wpirri/dom32-io-wifi/AuxMicroSD/montaje.png

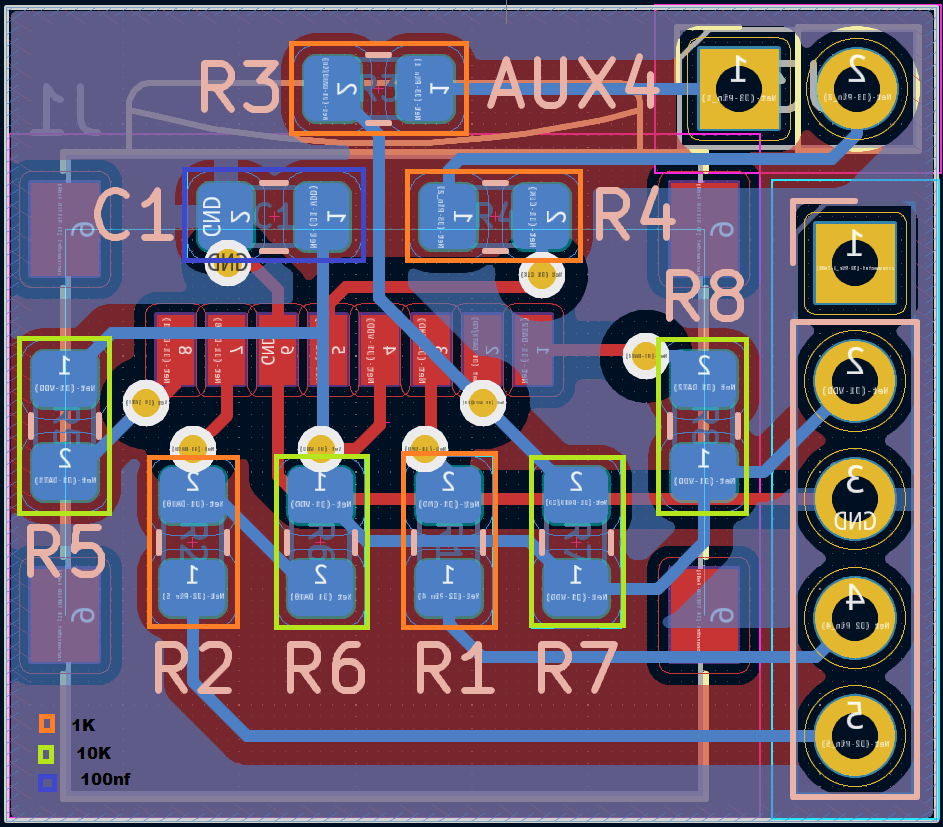
AuxMicroSD/montaje.png
