wpirri/dom32-io-wifi/Documento/Placa-LadoA.jpg

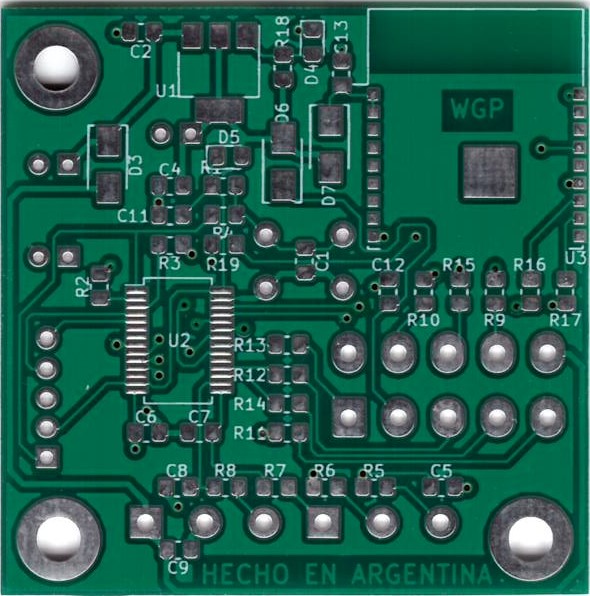
Documento/Placa-LadoA.jpg
