wpirri/dom32-io-wifi/Circuito/BOM.txt

"Component Count:","69"
"Ref","Qnty","Value","Cmp name","Footprint","Description","Vendor"
"C1, C2, C4, C5, C7, C8, C9, C10, C11, C12, C13, C16, ","12","100nf / 50v","C","Capacitor_SMD:C_0805_2012Metric_Pad1.18x1.45mm_HandSolder","Unpolarized capacitor",""
"C3, ","1","1000uf / 50v","C_Polarized","Capacitor_THT:CP_Radial_D8.0mm_P5.00mm","Polarized capacitor",""
"C6, C14, C15, C17, ","4","100uf / 16v","C_Polarized","Capacitor_THT:CP_Radial_D6.3mm_P2.50mm","Polarized capacitor",""
"D1, ","1","Led Azul","LED","Diode_SMD:D_0805_2012Metric_Pad1.15x1.40mm_HandSolder","Light emitting diode",""
"D2, ","1","Led Verde","LED","Diode_SMD:D_0805_2012Metric_Pad1.15x1.40mm_HandSolder","Light emitting diode",""
"D3, ","1","Led Amarillo","LED","Diode_SMD:D_0805_2012Metric_Pad1.15x1.40mm_HandSolder","Light emitting diode",""
"D4, D6, D7, ","3","M7","D","Diode_SMD:D_SMA","Diode",""
"D5, D8, D9, D10, D11, ","5","LL4148","D","Diode_SMD:D_SOD-128","Diode",""
"J1, ","1","Conector 1x5","Conn_01x05","Connector_PinHeader_2.54mm:PinHeader_1x05_P2.54mm_Vertical","Generic connector, single row, 01x05, script generated (kicad-library-utils/schlib/autogen/connector/)",""
"J2, J7, ","2","Bornera x2","Screw_Terminal_01x02","TerminalBlock_Phoenix:TerminalBlock_Phoenix_PT-1,5-2-5.0-H_1x02_P5.00mm_Horizontal","Generic screw terminal, single row, 01x02, script generated (kicad-library-utils/schlib/autogen/connector/)",""
"J3, J4, J6, ","3","Bornera x3","Screw_Terminal_01x03","TerminalBlock_Phoenix:TerminalBlock_Phoenix_PT-1,5-3-5.0-H_1x03_P5.00mm_Horizontal","Generic screw terminal, single row, 01x03, script generated (kicad-library-utils/schlib/autogen/connector/)",""
"J5, ","1","Conn_01x04","Conn_01x04","Connector_PinHeader_2.54mm:PinHeader_1x04_P2.54mm_Vertical","Generic connector, single row, 01x04, script generated (kicad-library-utils/schlib/autogen/connector/)",""
"K1, K2, K3, K4, ","4","FINDER-36.11","FINDER-36.11","Relay_THT:Relay_SPDT_Finder_36.11","FINDER 36.11, SPDT relay, 10A",""
"Q1, Q2, Q3, Q4, ","4","BC848","Q_NPN_BEC","Package_TO_SOT_SMD:SOT-23","NPN transistor, base/emitter/collector",""
"R1, ","1","10K","R","Resistor_SMD:R_0805_2012Metric_Pad1.20x1.40mm_HandSolder","Resistor",""
"R2, R3, R4, R5, R6, R7, R8, R9, R10, R11, R12, R15, R16, R17, R18, R19, R20, R21, ","18","1K","R","Resistor_SMD:R_0805_2012Metric_Pad1.20x1.40mm_HandSolder","Resistor",""
"R13, R14, R22, ","3","33R","R","Resistor_SMD:R_0805_2012Metric_Pad1.20x1.40mm_HandSolder","Resistor",""
"SW1, ","1","TactSwitch","SW_Push","Button_Switch_THT:SW_PUSH_6mm_H5mm","Push button switch, generic, two pins",""
"U1, ","1","ZLDO1117QG33TADICT-ND","LM1117-3.3","Package_TO_SOT_SMD:SOT-223-3_TabPin2","800mA Low-Dropout Linear Regulator, 3.3V fixed output, TO-220/TO-252/TO-263/SOT-223",""
"U2, ","1","PIC32MM0256GPM028-I-SS","PIC32MM0256GPM028-I-SS","Package_SO:SSOP-28_5.3x10.2mm_P0.65mm","",""
"U3, ","1","1965-ESP-WROOM-02D-N4CT-ND","ESP-02-DomIO32","RF_Module:ESP-WROOM-02","",""

MEM2067-02-180-00-A
