wpirri/dom32-io-wifi/Documento/Entradas y Salidas.pdf

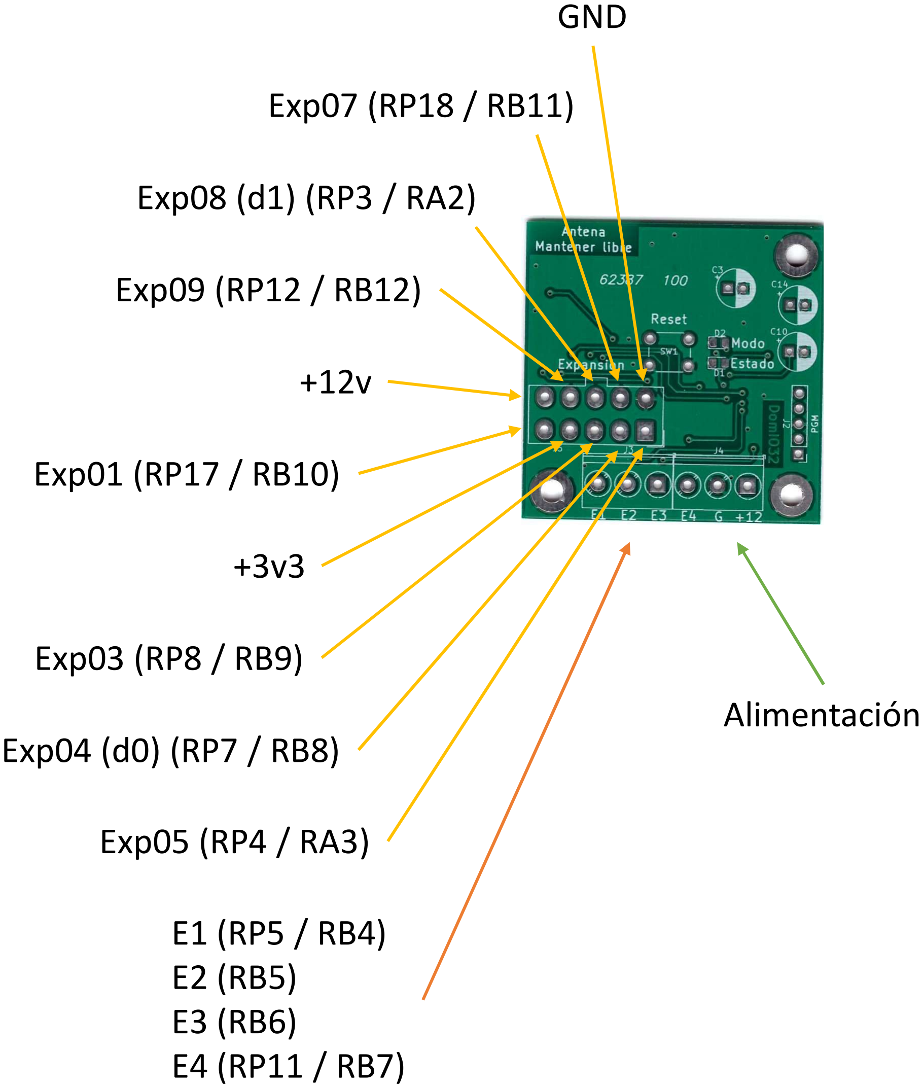
[picture p3: figure]
GND; Exp07 (RP18 / RB11); Exp08 (d1) (RP3 / RA2); Exp09 (RP12 / RB12); Exp01 (RP17 / RB10); Exp03 (RP8 / RB9); Exp04 (d0) (RP7 / RB8); Exp05 (RP4 / RA3); Alimentación
