wpirri/dom32-io-wifi/AuxMicroSD/instalacion_parche.jpg

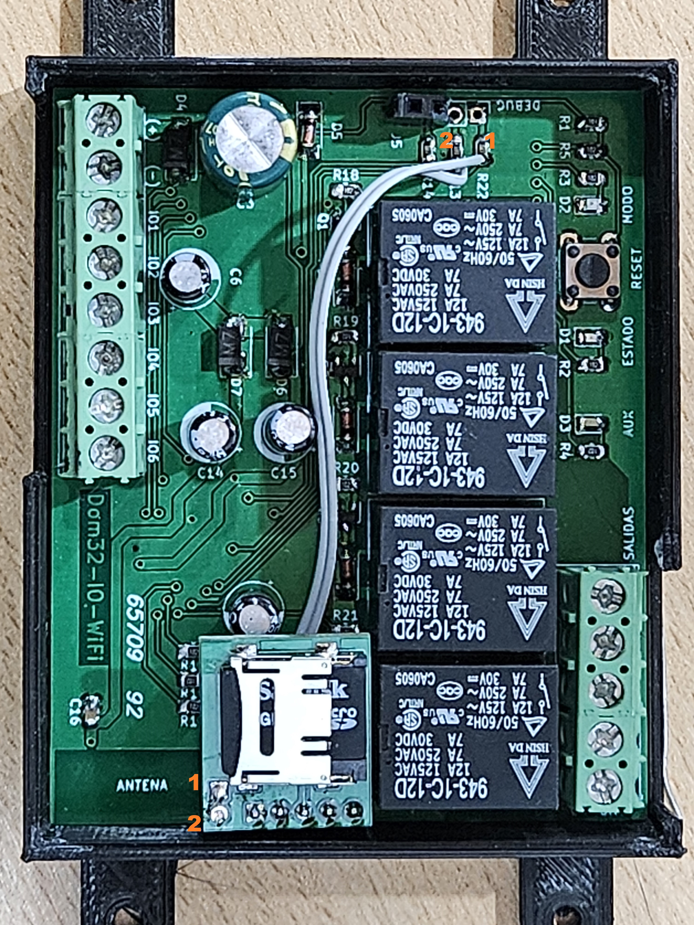
AuxMicroSD/instalacion_parche.jpg
