wpirri/dom32-io-wifi/Documento/2023-01-29 13.07.53.jpg

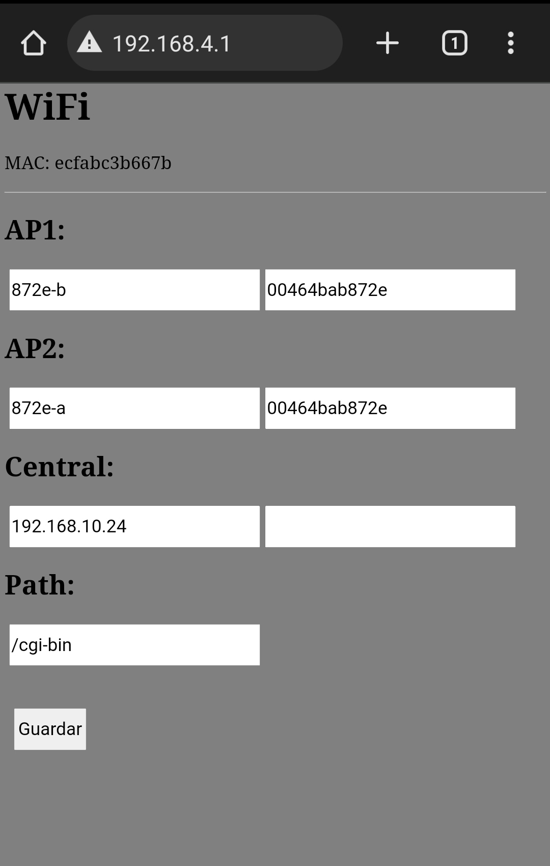
Documento/2023-01-29 13.07.53.jpg
