wpirri/dom32-io-wifi/Documento/DomIO32-3D-Fdo.jpg

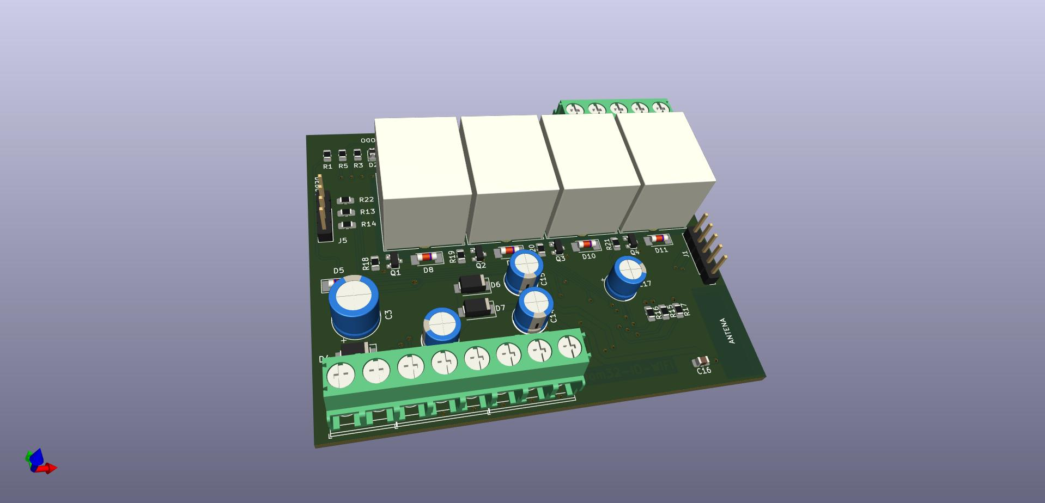
Documento/DomIO32-3D-Fdo.jpg
