wpirri/dom32-io-wifi/Documento/DomIO32-3D-Fte.jpg

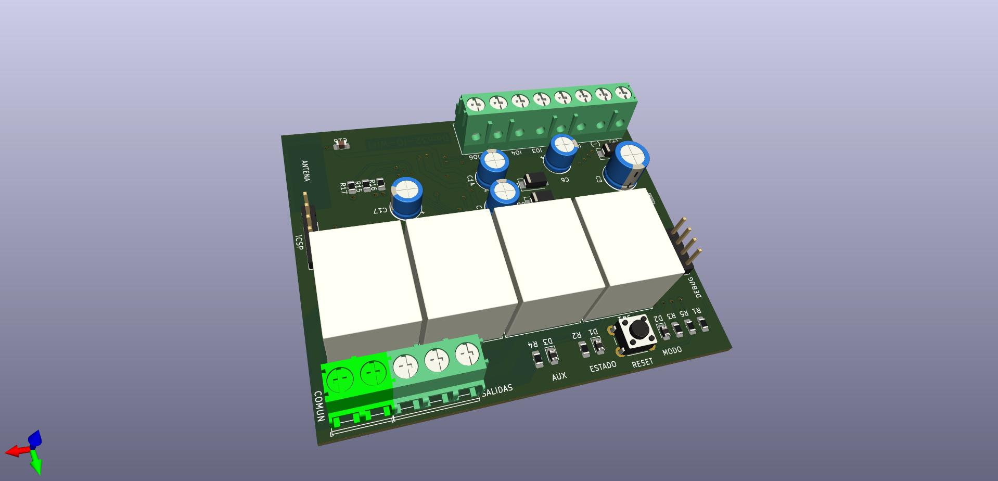
Documento/DomIO32-3D-Fte.jpg
