wpirri/dom32-io-wifi/Documento/DomIO32-3D-Inf.jpg

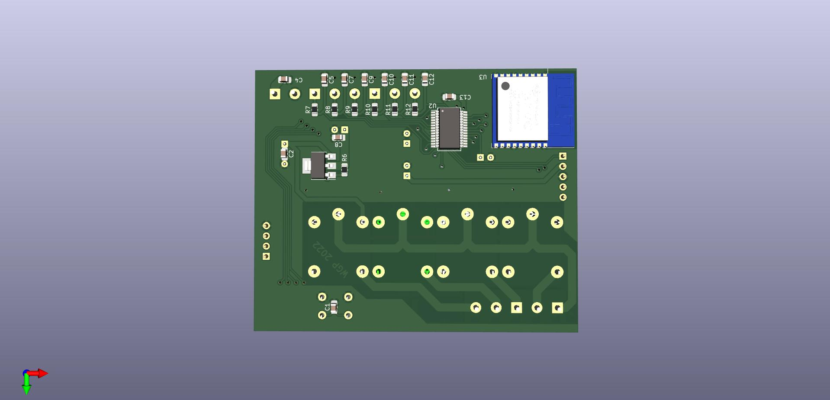
Documento/DomIO32-3D-Inf.jpg
