wpirri/dom32-io-wifi/Documento/DomIO32-3D-Sup.jpg

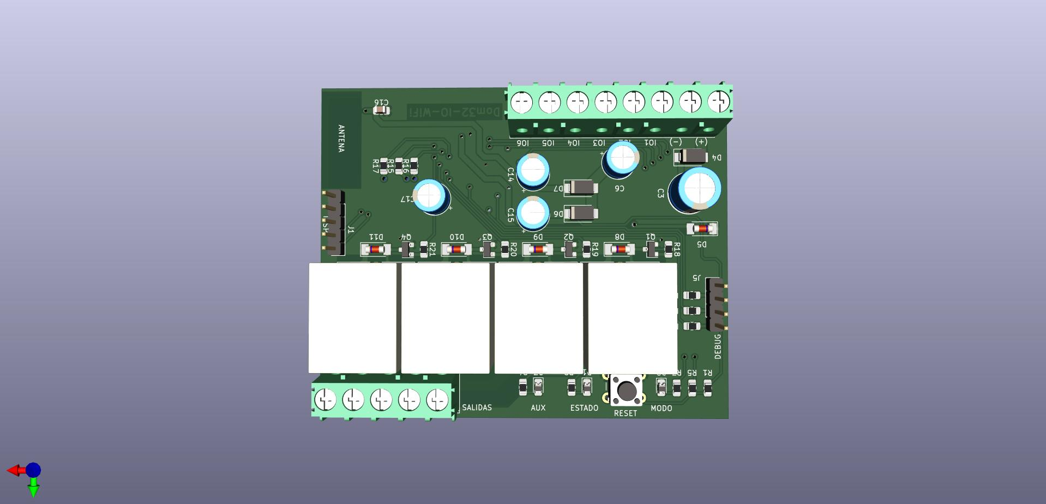
Documento/DomIO32-3D-Sup.jpg
