wpirri/dom32-io-wifi/Documento/getio.png

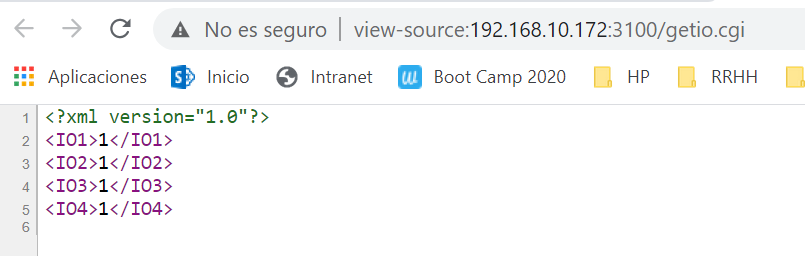
Documento/getio.png
