wpirri/dom32-io-wifi/Documento/Placa-LadoB.jpg

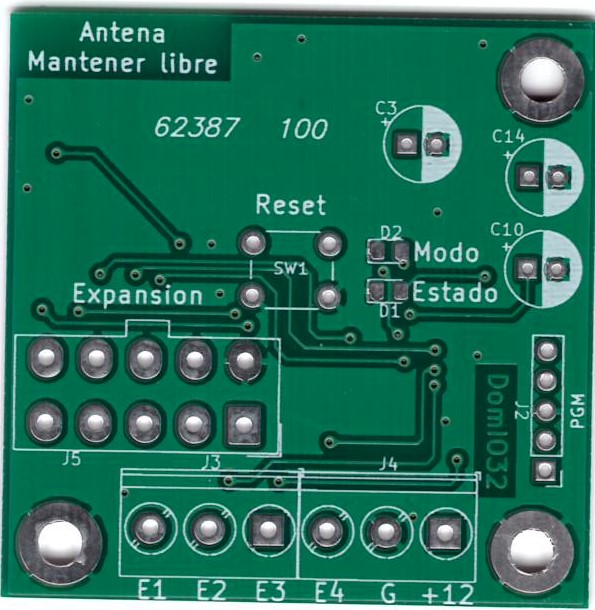
Documento/Placa-LadoB.jpg
