wpirri/dom32-io-wifi/Documento/placa.png

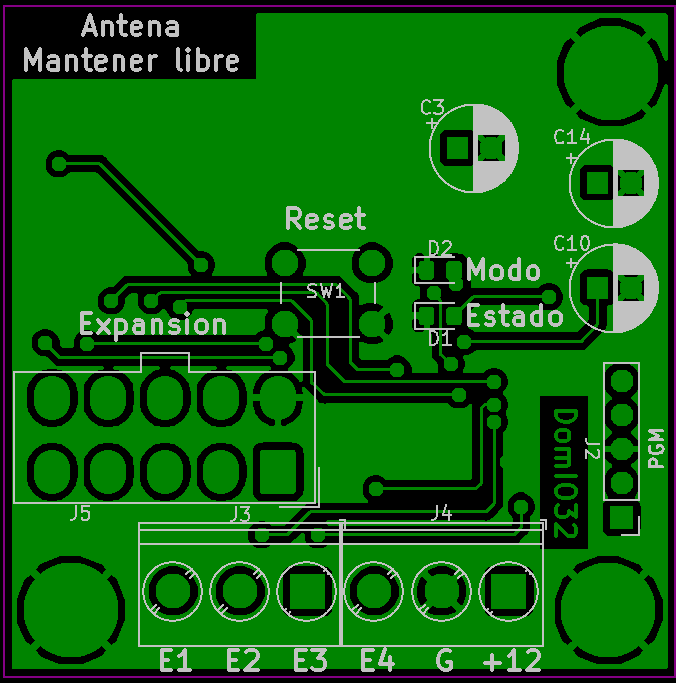
Documento/placa.png
