wpirri/dom32-io-wifi/Documento/Componentes.txt

ESP-WROOM-02D

PIC32MM0256GPM028-I/SS

Alternativas:
    PIC32MM0256GPM028-E/SS      Rango extendido de temperaturas
    PIC32MM0256GPM028T-I/SS     Embalado en Tape & Reel

Orificio 1,25

Conector
CONN RCPT HSG 10POS 4.20MM
DKPN: WM19548-ND

CONN HEADER VERT 10POS 4.2MM
DKPN: WM20747-ND
