wpirri/dom32-io-wifi/Documento/Materiales.xlsx

Componente | Valor | DigiKey | Cantidad | Unitario | Por placa
Resistencia SMD 0805 | 1K | 13-RC0805JR-131KLCT-ND | 18 | 0.10 | 1.80
Resistencia SMD 0805 | 10K | 311-10KARCT-ND | 1 | 0.10 | 0.10
Resistencia SMD 0805 | 33R | 311-33ARCT-ND | 3 | 0.10
Capacitor ceramico SMD 0805 | 100nf / 50v | 3372-0805B104K500BDTR-ND | 12 | 0.05 | 0.60
Capacitor electrolitico | 1000uf / 25v | 732-8835-1-ND | 1 | 0.57 | 0.57
Capacitor electrolitico | 100uf / 25v | 732-8630-1-ND | 4 | 0.13 | 0.52
Led SMD 0805 | Verde | 3147-B1701NG--20D000314U1930CT-ND | 1 | 0.11 | 0.11
Led SMD 0805 | Azul | 3147-B1701NB--20D000114U1930CT-ND | 1 | 0.10 | 0.10
Led SMD 0805 | Amarillo | 3147-B1701UY--20D000214U1930CT-ND | 1 | 0.10 | 0.10
Diodo | M7 | 3372-M7TR-ND | 3 | 0.10 | 0.30
Diodo | LL4148 | LL4148-GS08CT-ND | 5 | 0.17 | 0.85
Transistor | BC847 | BC847C-TPCT-ND | 4 | 0.14 | 0.56
Bornera x 2 | DG128-B2V | 277-1667-ND | 2 | 0.52 | 1.04
Bornera x 3 | DG128-B3V | 277-1578-ND | 3 | 0.71 | 2.13
Relee 12v 10A | 943-Series | 3385-AZ943-1CH-12DE-ND | 4 | 0.65 | 2.60
Tact Switch | 6x6x5 mm | 486-3458-ND | 1 | 0.23 | 0.23
Regulador SOT-223 | ZLDO1117 | ZLDO1117QG33TADICT-ND | 1 | 0.67 | 0.67
Procesador | PIC32MM0256GPM028-I/SS (E/SS) | PIC32MM0256GPM028-I/SS-ND | 1 | 2.92 | 2.92
Modulo Wifi | ESP-WROOM-02 | 1965-ESP-WROOM-02D-N4CT-ND | 1 | 3.20 | 3.20
Circuito impreso | MAYER_65709-42 |  | 1 | 7.40 | 7.40
 |  |  |  |  | 0.00
 |  |  |  |  | 0.00
 |  |  |  |  | 0.00
 |  |  |  |  | 0.00
 |  |  |  |  | 0.00
 |  |  | Total |  | 25.80
