wpirri/dom32-io-wifi/Gabinete/dom32-io-wifi-tapa-con-logo.3mf

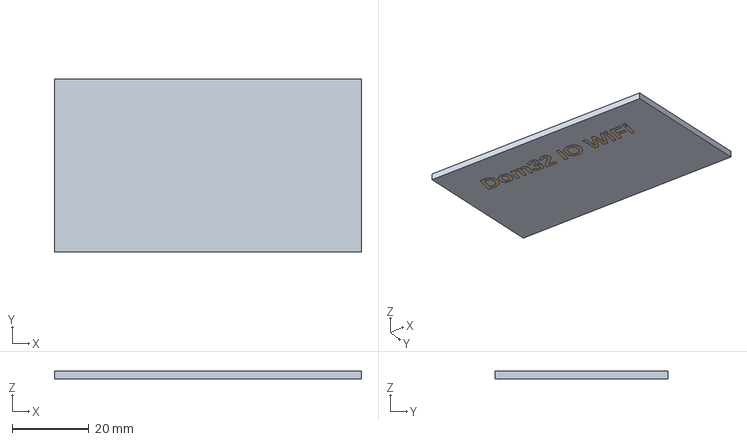
[picture p13: CAD file, 2022-09-06]
Gabinete/dom32-io-wifi-tapa-con-logo.3mf
80.0 x 45.0 x 2.00 mm
dom32-io-wifi-gabinete-tapa-superior.stl
dom32-io-wifi-gabinete-logo.stl
