wpirri/dom32-io-wifi/Gabinete/TODO.txt

Ranuras de ventilacion para sensor de humedad y temperatura
