wpirri/dom32-io-wifi/Circuito/DomIO32v2.pdf

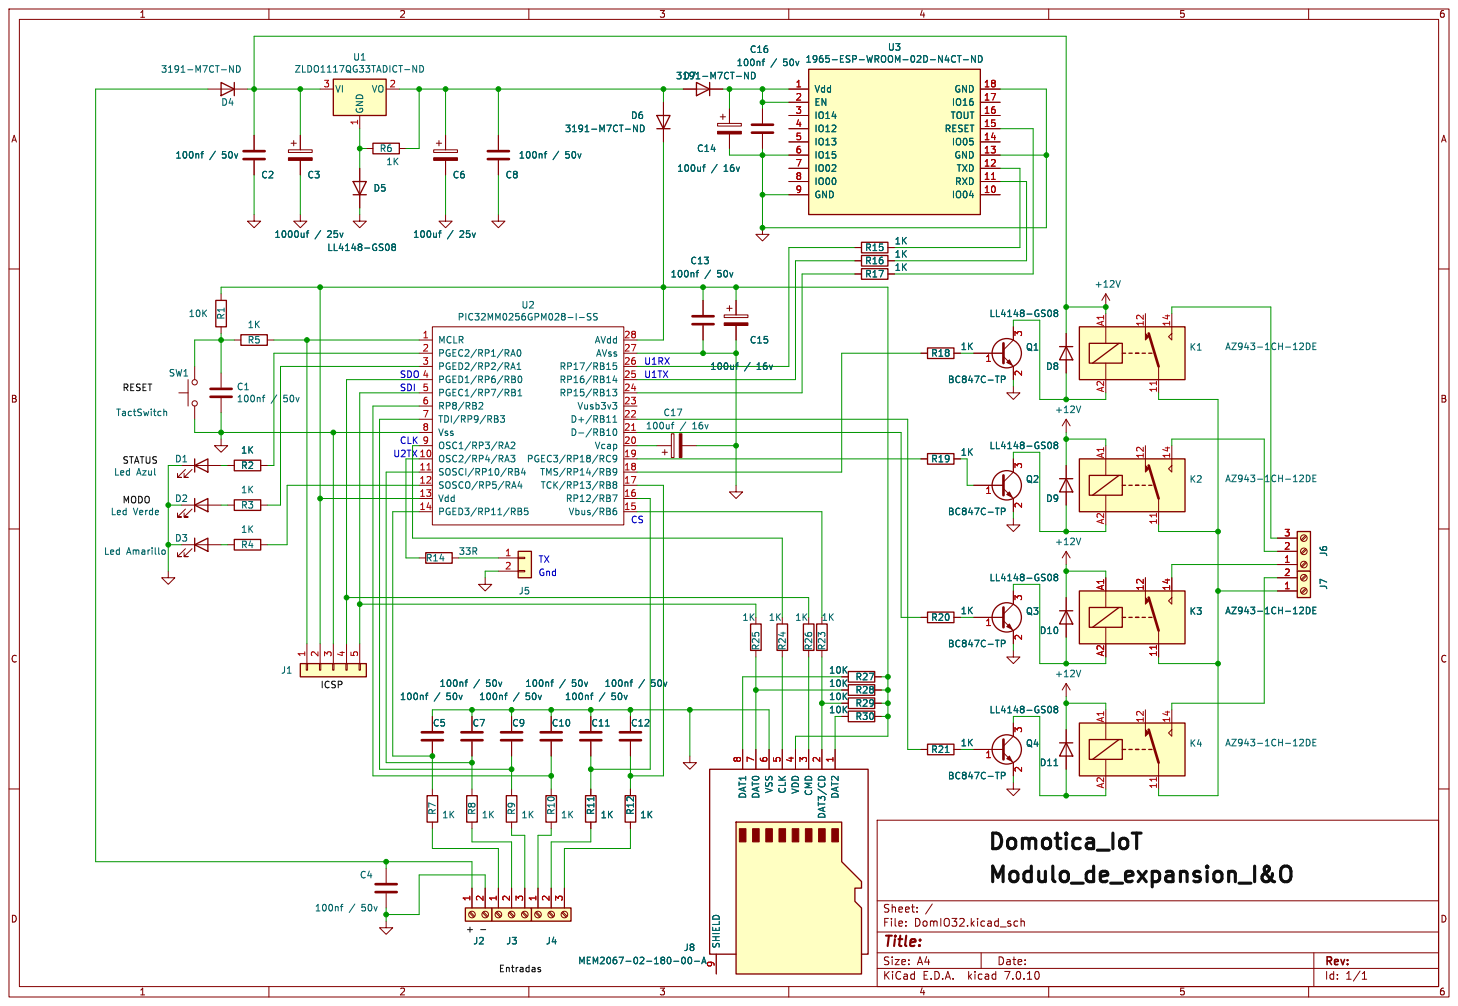
[picture p17: page 1]

1 VO 2 VI 3 U1 ZLDO1117QG33TADICT-ND 3191-M7CT-ND D7 C1

Id: 1/1 Title: File: DomIO32.kicad_sch Sheet: /
