wpirri/dom32-io-wifi/Circuito/DomIO32.pdf

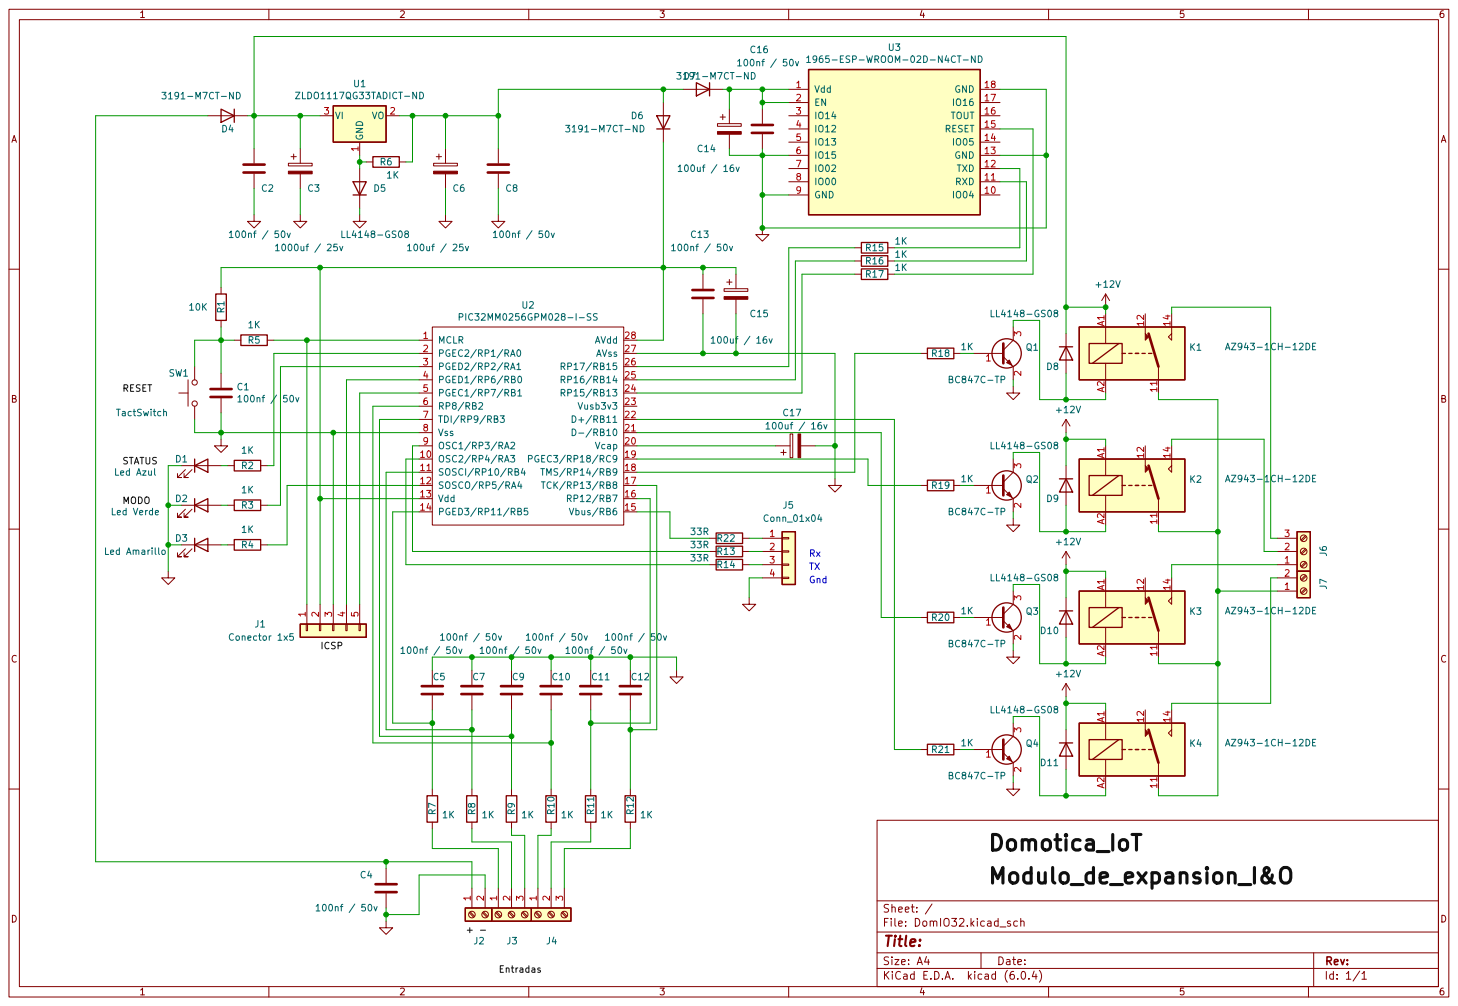
[picture p18: page 1]
