wpirri/dom32-io-wifi/Circuito/Circuito.pdf

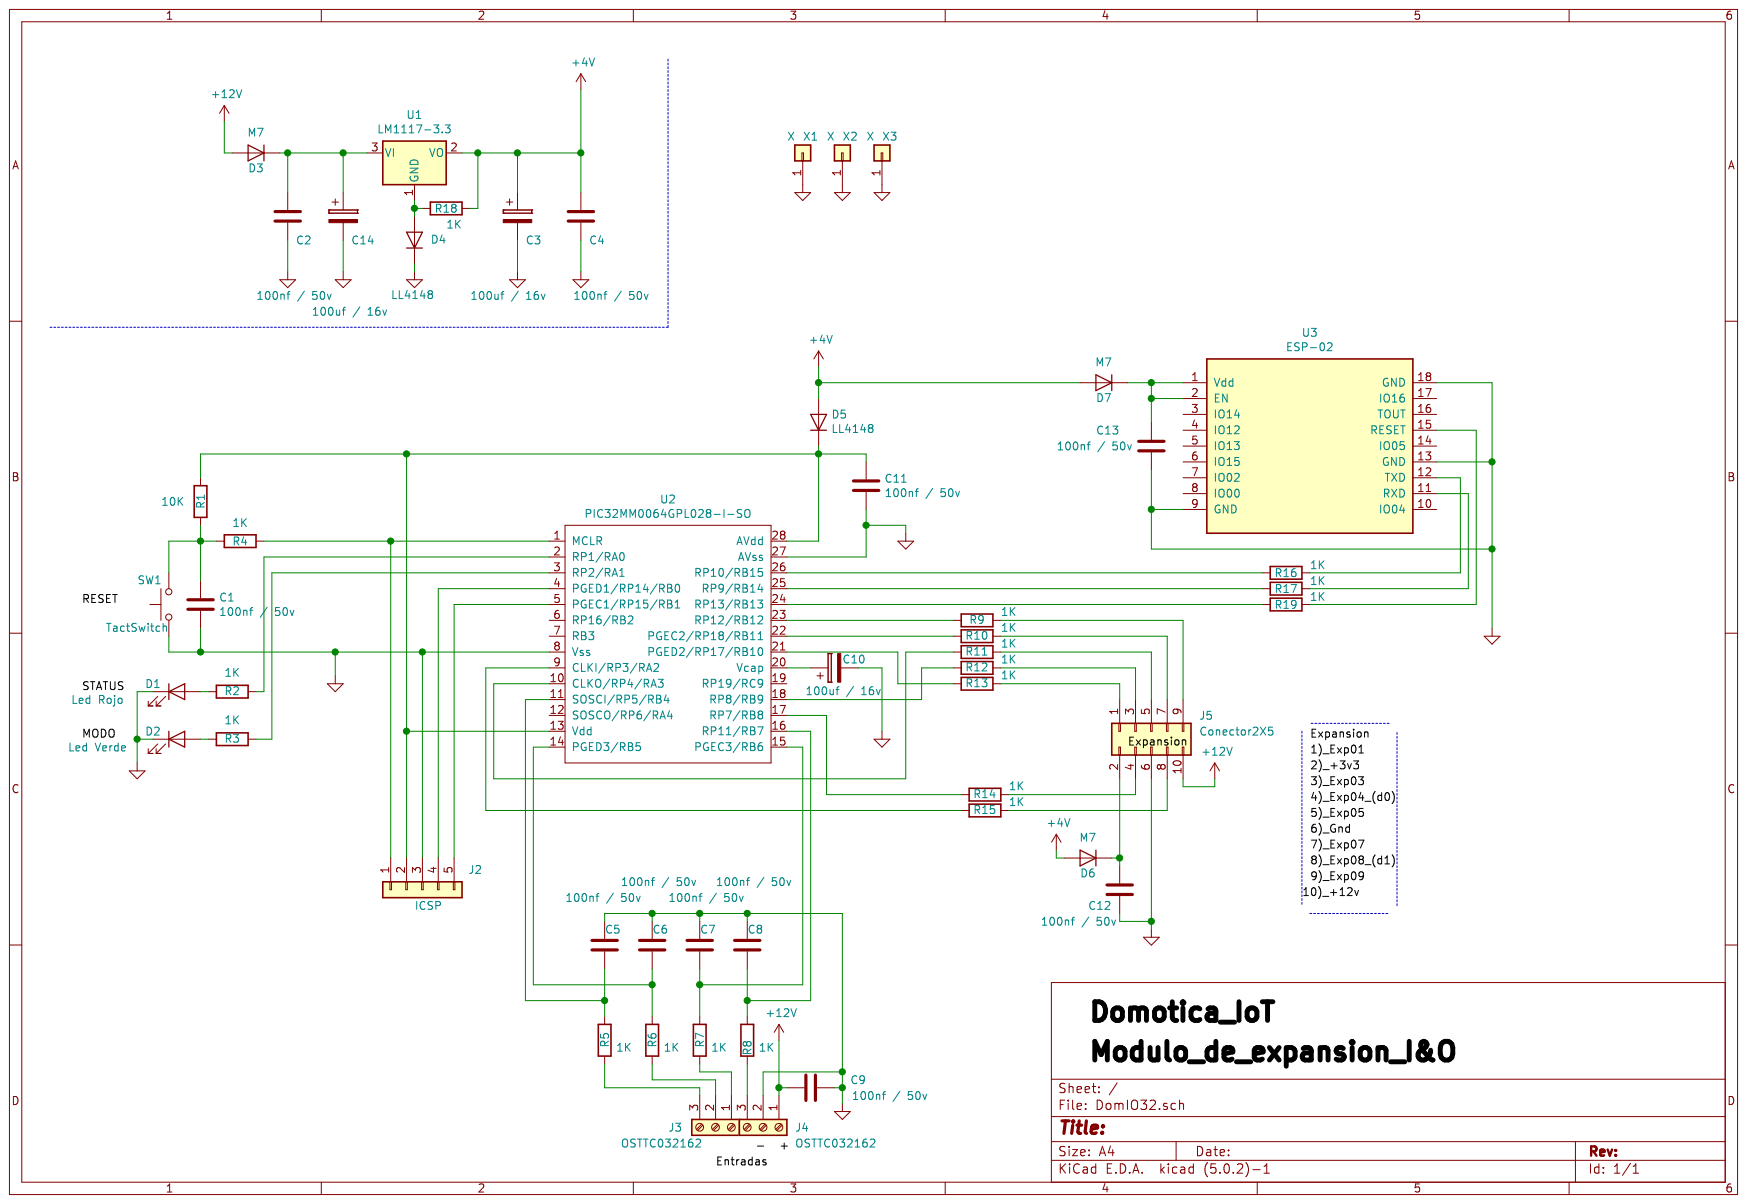
[picture p19: page 1]
