wpirri/dom32-io-wifi/Circuito/DomIO32.kicad_pcb

## KiCad design Circuito/DomIO32.kicad_pcb (2024-06-20)

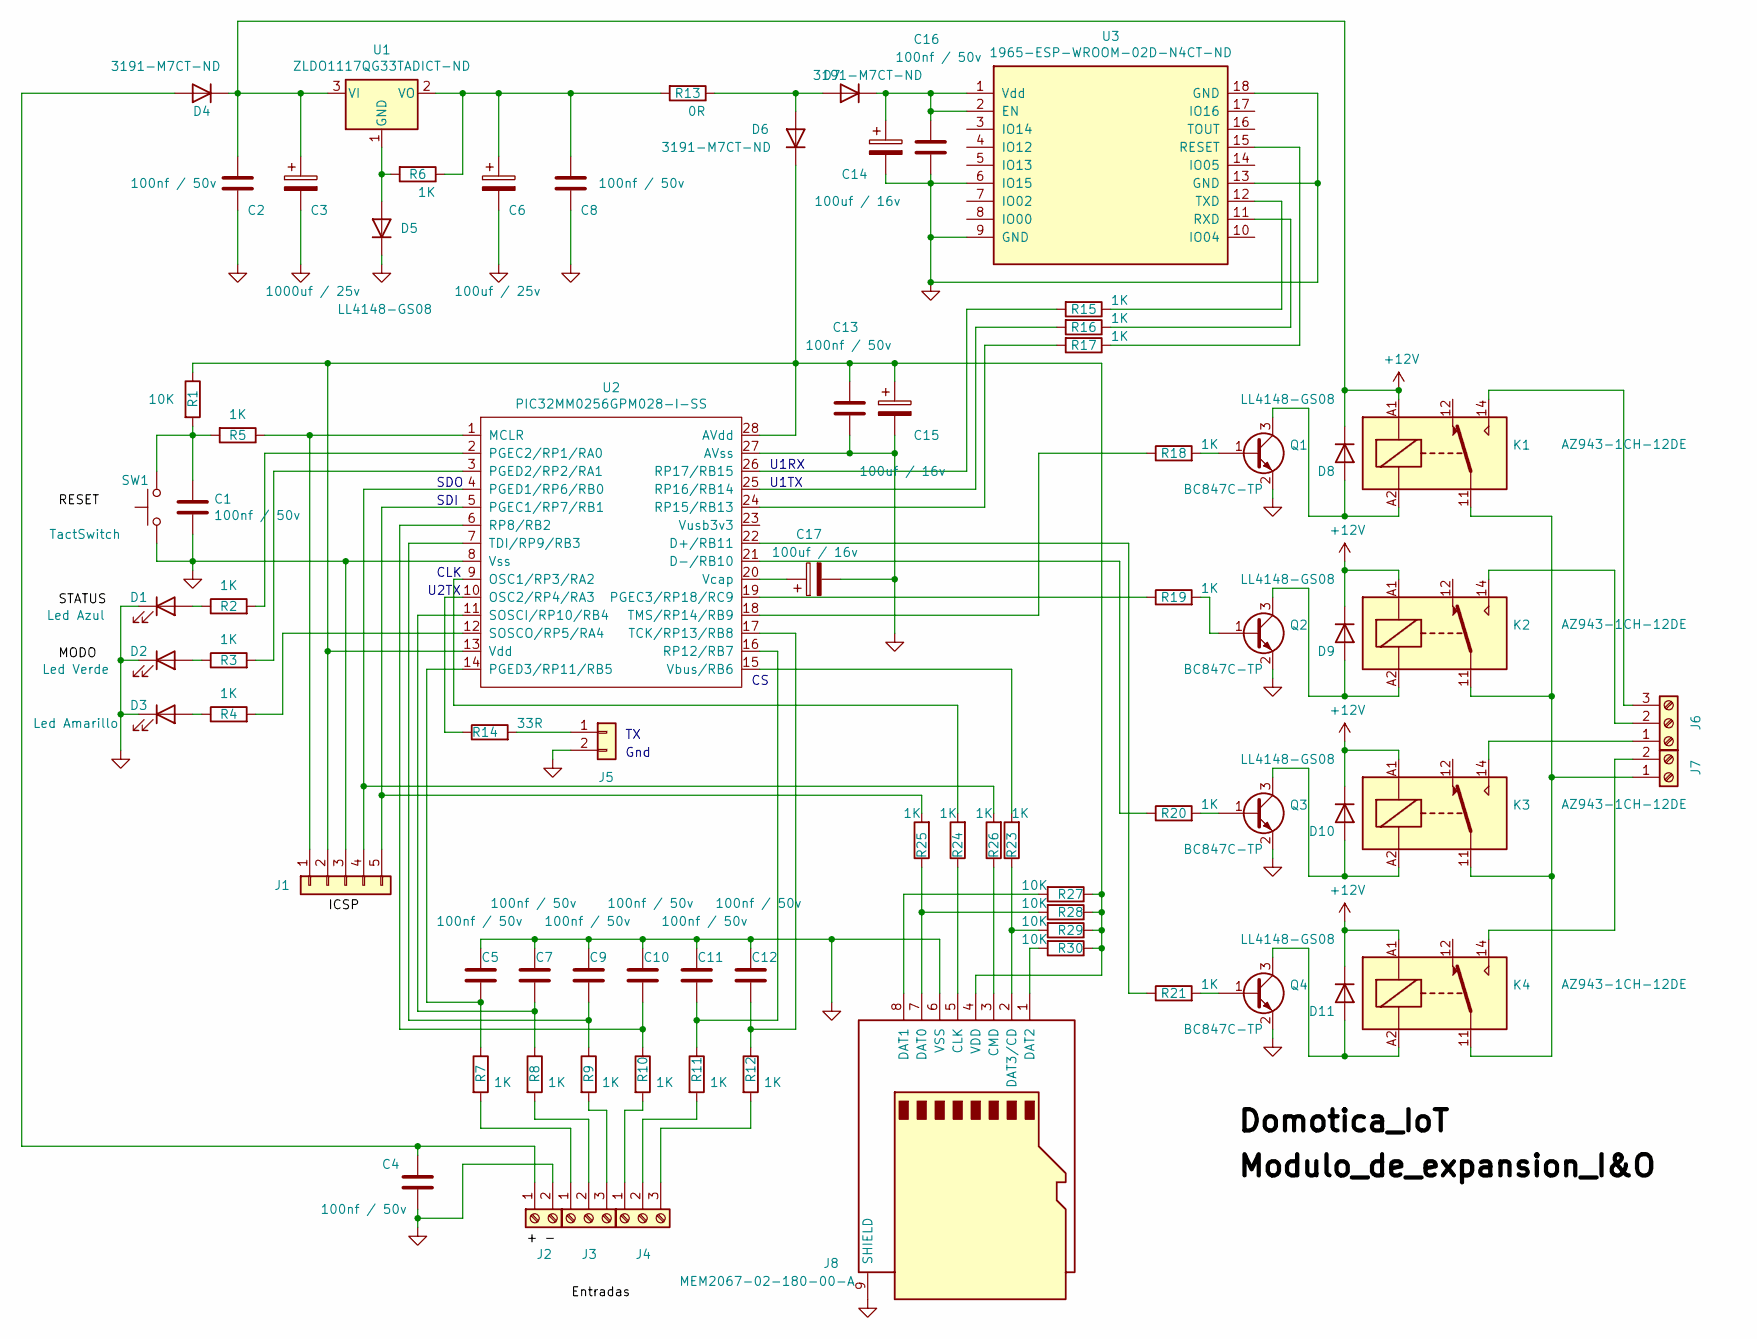
[picture p20: schematic DomIO32.kicad_sch]

Parts:
C1, C2, C4, C5, C7, C8, C9, C10, C11, C12, C13, C16: 100nf / 50v; C_0805_2012Metric_Pad1.18x1.45mm_HandSolder
C3: 1000uf / 25v; CP_Radial_D8.0mm_P5.00mm
C6: 100uf / 25v; CP_Radial_D6.3mm_P2.50mm
C14, C15, C17: 100uf / 16v; CP_Radial_D6.3mm_P2.50mm
D1: Led Azul; D_0805_2012Metric_Pad1.15x1.40mm_HandSolder
D2: Led Verde; D_0805_2012Metric_Pad1.15x1.40mm_HandSolder
D3: Led Amarillo; D_0805_2012Metric_Pad1.15x1.40mm_HandSolder
D4, D6, D7: 3191-M7CT-ND; D_SMA
D5, D8, D9, D10, D11: LL4148-GS08; D_SOD-128
J1: Poste X 5; PinHeader_1x05_P2.54mm_Vertical
J2, J7: 277-1667-ND; TerminalBlock_Phoenix_PT-1,5-2-5.0-H_1x02_P5.00mm_Horizontal
J3, J4, J6: 277-1578-ND; TerminalBlock_Phoenix_PT-1,5-3-5.0-H_1x03_P5.00mm_Horizontal
J5: Poste X 2; PinHeader_1x02_P2.54mm_Vertical
J8: MEM2067-02-180-00-A; microSD_HC_Wuerth_693072010801
K1, K2, K3, K4: AZ943-1CH-12DE; Relay_SPDT_Finder_36.11
Q1, Q2, Q3, Q4: BC847C-TP; SOT-23
R1, R27, R28, R29, R30: 10K; R_0805_2012Metric_Pad1.20x1.40mm_HandSolder
R2, R3, R4, R5, R6, R7, R8, R9, R10, R11, R12, R15, R16, R17, R18, R19, R20, R21, R23, R24, R25, R26: 1K; R_0805_2012Metric_Pad1.20x1.40mm_HandSolder
R13: 0R; R_0805_2012Metric_Pad1.20x1.40mm_HandSolder
R14: 33R; R_0805_2012Metric_Pad1.20x1.40mm_HandSolder
SW1: TactSwitch; SW_PUSH_6mm_H5mm
U1: ZLDO1117QG33TADICT-ND; SOT-223-3_TabPin2
U2: PIC32MM0256GPM028-I-SS; SSOP-28_5.3x10.2mm_P0.65mm
U3: 1965-ESP-WROOM-02D-N4CT-ND; ESP-WROOM-02

Connections:
+12V: C2.1, C3.1, D4.1 (K), D8.1 (K), D9.1 (K), D10.1 (K), D11.1 (K), K1.A1, K2.A1, K3.A1, K4.A1, U1.3 (VI)
GND: C1.2, C2.2, C3.2, C4.1, C5.1, C6.2, C7.1, C8.2, C9.1, C10.1, C11.1, C12.1, C13.2, C14.2, C15.2, C16.2, C17.2, D1.1 (K), D2.1 (K), D3.1 (K), D5.1 (K), J1.3, J2.2, J5.2, J8.6 (VSS), J8.9 (SHIELD), Q1.2 (E), Q2.2 (E), Q3.2 (E), Q4.2 (E), SW1.1, U2.8 (Vss), U2.27 (AVss), U3.6 (IO15), U3.9 (GND), U3.13 (GND), U3.18 (GND)
unnamed: C1.1, R1.2, R5.2, SW1.2
unnamed: D1.2 (A), R2.1
unnamed: D2.2 (A), R3.1
unnamed: D3.2 (A), R4.1
unnamed: C4.2, D4.2 (A), J2.1
unnamed: D5.2 (A), R6.2, U1.1 (GND)
unnamed: D6.2 (A), D7.2 (A), R13.1
unnamed: C13.1, C15.1, D6.1 (K), J1.2, J8.4 (VDD), R1.1, R27.1, R28.1, R29.1, R30.1, U2.13 (Vdd), U2.28 (AVdd)
unnamed: C14.1, C16.1, D7.1 (K), U3.1 (Vdd), U3.2 (EN)
unnamed: D8.2 (A), K1.A2, Q1.3 (C)
unnamed: D9.2 (A), K2.A2, Q2.3 (C)
unnamed: D10.2 (A), K3.A2, Q3.3 (C)
unnamed: D11.2 (A), K4.A2, Q4.3 (C)
unnamed: J1.1, R5.1, U2.1 (MCLR)
unnamed: J1.4, R26.2, U2.4 (PGED1/RP6/RB0)
unnamed: J1.5, R25.2, U2.5 (PGEC1/RP7/RB1)
unnamed: J3.1, R7.2
unnamed: J3.2, R8.2
unnamed: J3.3, R9.2
unnamed: J4.1, R10.2
unnamed: J4.2, R11.2
unnamed: J4.3, R12.2
unnamed: J5.1, R14.2
unnamed: J6.1, K3.14
unnamed: J6.2, K2.14
unnamed: J6.3, K1.14
unnamed: J7.1, K1.11, K2.11, K3.11, K4.11
unnamed: J7.2, K4.14
unnamed: J8.5 (CLK), R24.1
unnamed: J8.3 (CMD), R26.1
unnamed: J8.7 (DAT0), R25.1, R28.2
unnamed: J8.8 (DAT1), R27.2
unnamed: J8.1 (DAT2), R30.2
unnamed: J8.2 (DAT3/CD), R23.1, R29.2
unnamed: Q1.1 (B), R18.2
unnamed: Q2.1 (B), R19.2
unnamed: Q3.1 (B), R20.2
unnamed: Q4.1 (B), R21.2
unnamed: C6.1, C8.1, R6.1, R13.2, U1.2 (VO)
unnamed: R21.1, U2.22 (D+/RB11)
unnamed: R20.1, U2.21 (D-/RB10)
unnamed: R24.2, U2.9 (OSC1/RP3/RA2)
unnamed: R14.1, U2.10 (OSC2/RP4/RA3)
unnamed: R2.2, U2.2 (PGEC2/RP1/RA0)
unnamed: R19.1, U2.19 (PGEC3/RP18/RC9)
unnamed: R3.2, U2.3 (PGED2/RP2/RA1)
unnamed: C5.2, R7.1, U2.14 (PGED3/RP11/RB5)
unnamed: C10.2, R10.1, U2.6 (RP8/RB2)
unnamed: C11.2, R11.1, U2.16 (RP12/RB7)
unnamed: R17.2, U2.24 (RP15/RB13)
unnamed: R16.2, U2.25 (RP16/RB14)
unnamed: R15.2, U2.26 (RP17/RB15)
unnamed: C7.2, R8.1, U2.11 (SOSCI/RP10/RB4)
unnamed: R4.2, U2.12 (SOSCO/RP5/RA4)
unnamed: C12.2, R12.1, U2.17 (TCK/RP13/RB8)
unnamed: C9.2, R9.1, U2.7 (TDI/RP9/RB3)
unnamed: R18.1, U2.18 (TMS/RP14/RB9)
unnamed: R23.2, U2.15 (Vbus/RB6)
unnamed: C17.1, U2.20 (Vcap)
unnamed: R17.1, U3.15 (RESET)
unnamed: R16.1, U3.11 (RXD)
unnamed: R15.1, U3.12 (TXD)

Notes on the sheet:
U1TX
SDO
SDI
Gnd
U1RX
U2TX
CLK

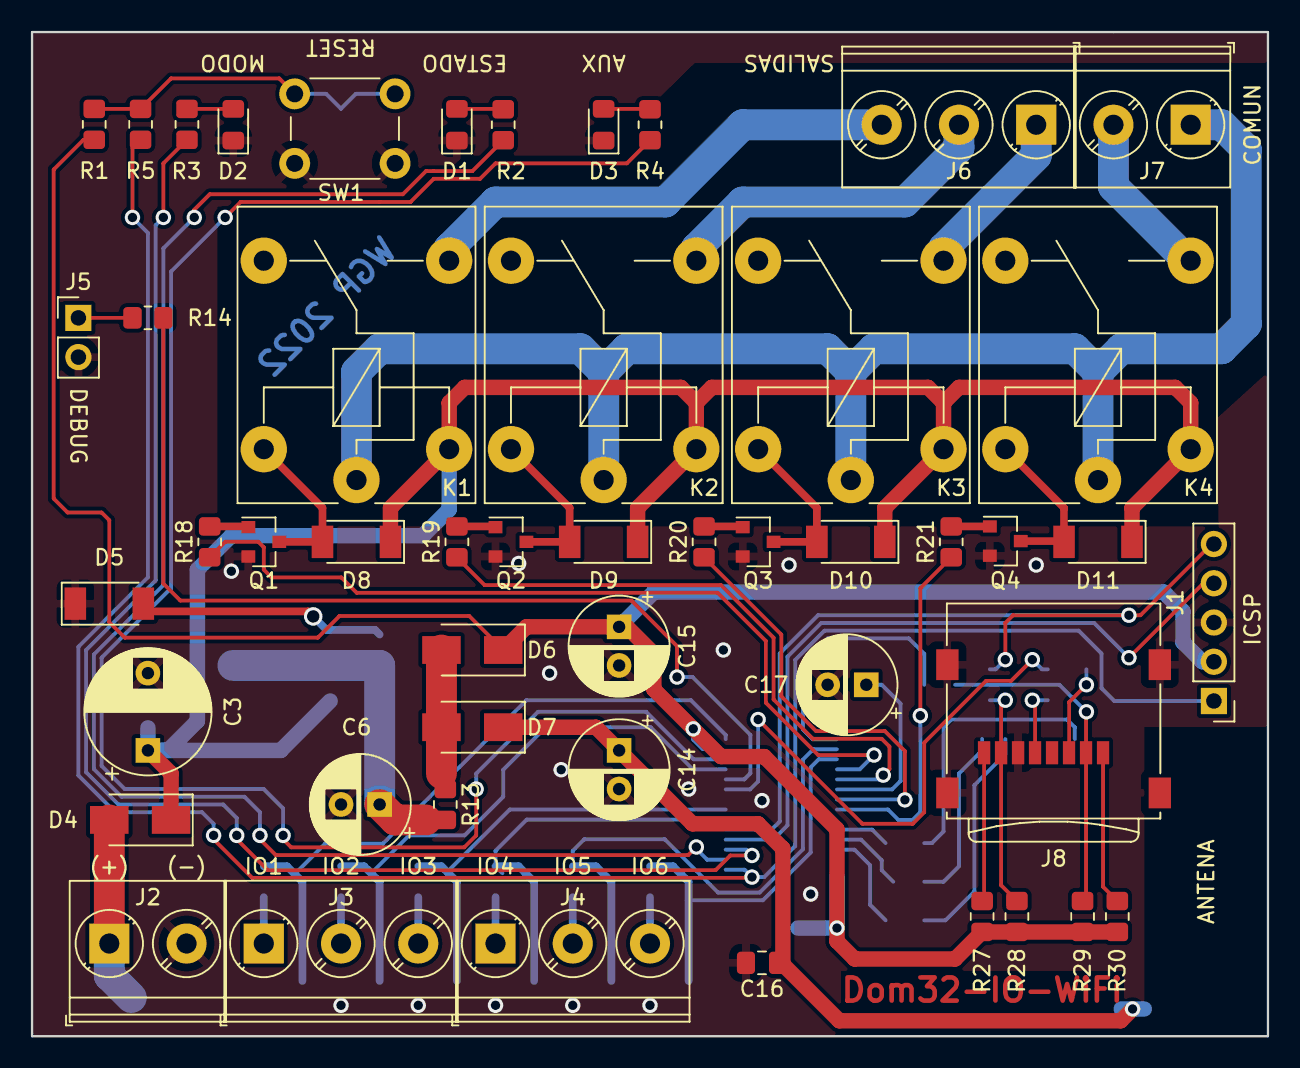
[picture p21: board DomIO32.kicad_pcb from above]

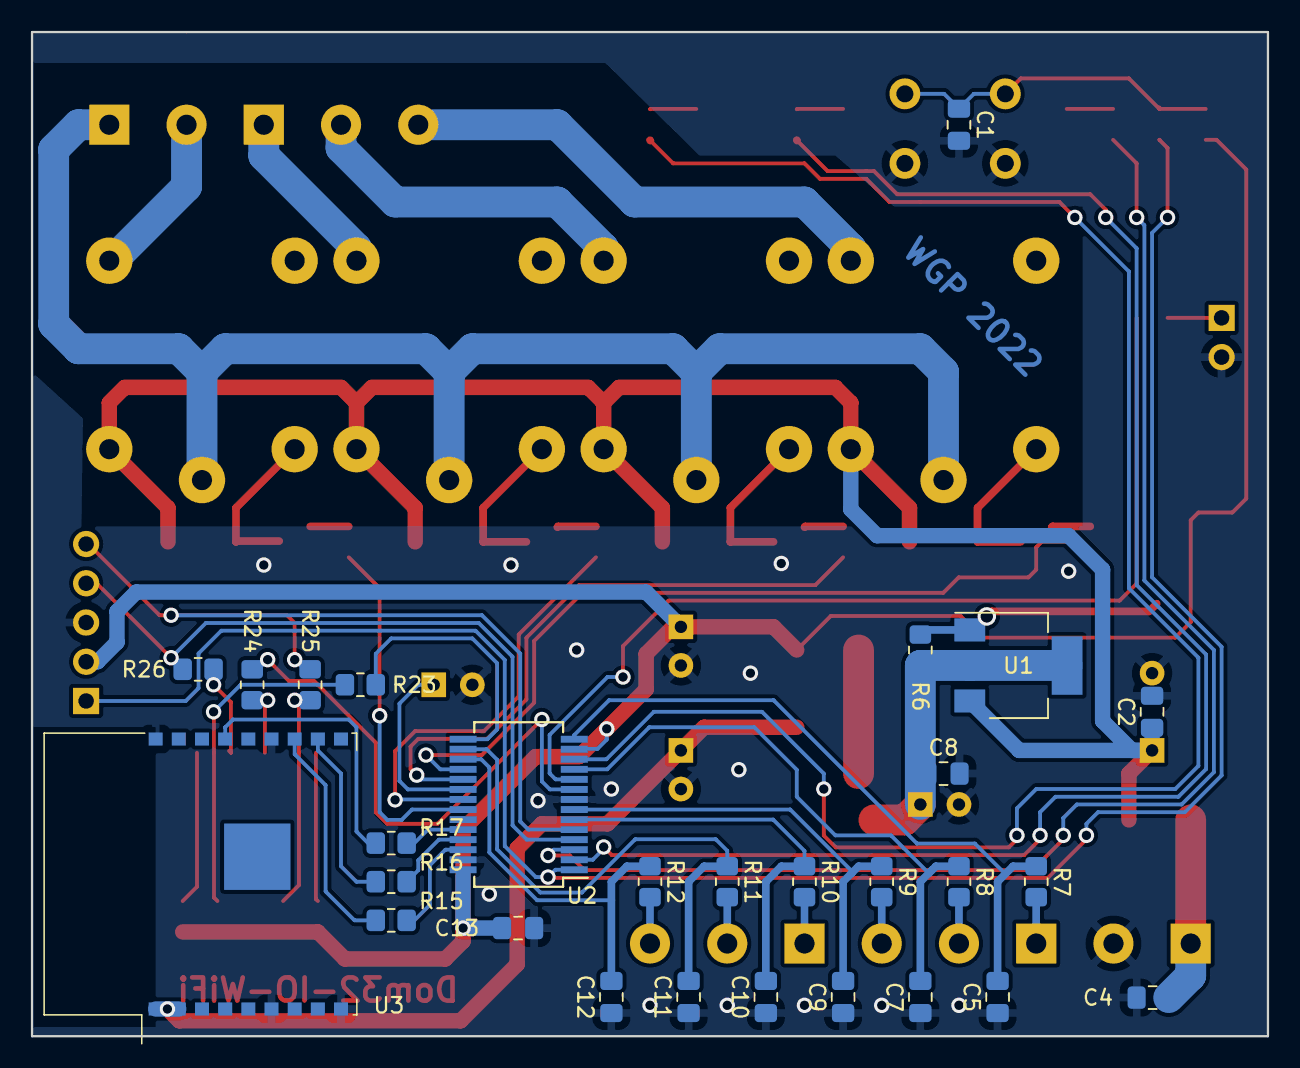
[picture p22: board DomIO32.kicad_pcb from below]

Board: 2 copper layers, 80.0 x 65.0 mm, 77 parts (28 on the bottom side), 64 nets.
