wpirri/dom32-io-wifi/AuxMicroSD/auxmicrosd.kicad_pcb

## KiCad design AuxMicroSD/auxmicrosd.kicad_pcb (2024-05-24)

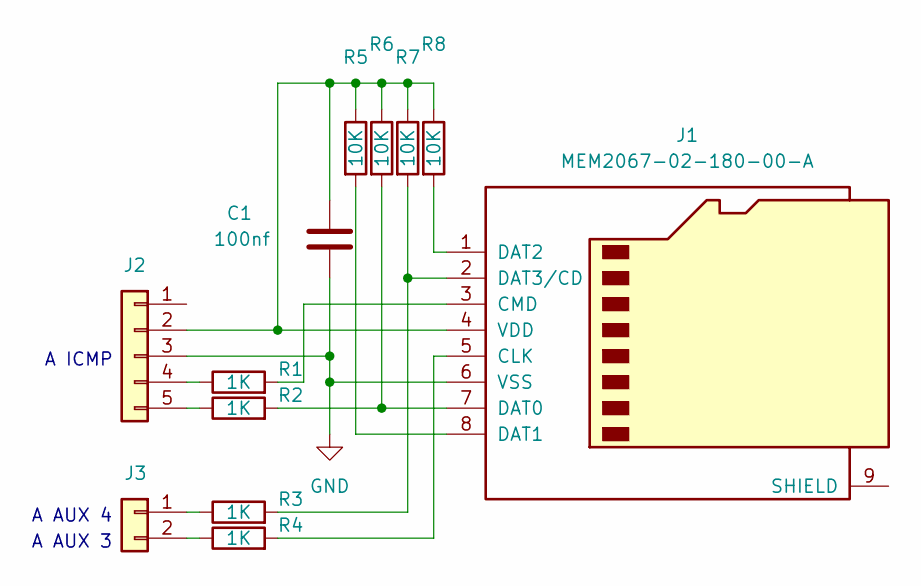
[picture p23: schematic auxmicrosd.kicad_sch]

Parts:
C1: 100nf; C_0805_2012Metric_Pad1.18x1.45mm_HandSolder
J1: MEM2067-02-180-00-A; microSD_HC_Wuerth_693072010801
J2: Poste X 5; PinHeader_1x05_P2.54mm_Vertical
J3: Poste X 2; PinHeader_1x02_P2.54mm_Vertical
R1, R2, R3, R4: 1K; R_0805_2012Metric_Pad1.20x1.40mm_HandSolder
R5, R6, R7, R8: 10K; R_0805_2012Metric_Pad1.20x1.40mm_HandSolder

Connections:
GND: C1.2, J1.6 (VSS), J2.3
unnamed: J1.5 (CLK), R4.2
unnamed: J1.3 (CMD), R1.2
unnamed: J1.7 (DAT0), R2.2, R6.2
unnamed: J1.8 (DAT1), R5.2
unnamed: J1.1 (DAT2), R8.2
unnamed: J1.2 (DAT3/CD), R3.2, R7.2
unnamed: C1.1, J1.4 (VDD), J2.2, R5.1, R6.1, R7.1, R8.1
unnamed: J2.4, R1.1
unnamed: J2.5, R2.1
unnamed: J3.1, R3.1
unnamed: J3.2, R4.1

Notes on the sheet:
A AUX 3
A AUX 4
A ICMP

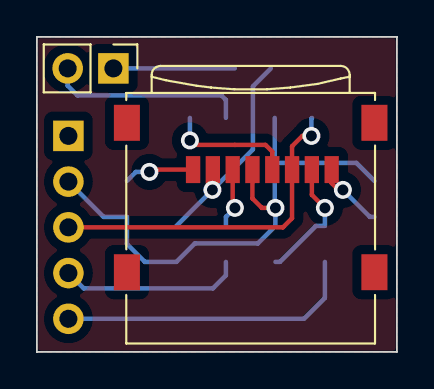
[picture p24: board auxmicrosd.kicad_pcb from above]

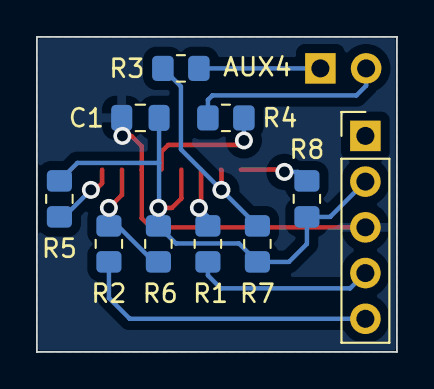
[picture p25: board auxmicrosd.kicad_pcb from below]

Board: 2 copper layers, 20.0 x 17.5 mm, 12 parts (10 on the bottom side), 12 nets.
