wpirri/dom32-io-wifi/Programa/main.c

/***************************************************************************
    Copyright (C) 2020   Walter Pirri

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
    You should have received a copy of the GNU Lesser General Public
    License along with this library; if not, write to the Free Software
    Foundation, Inc., 59 Temple Place, Suite 330, Boston, MA  02111-1307  USA
 ***************************************************************************/

/* *****************************************************************************
 * Asignaci�n de pines para PIC32MM0064GPL028 en DomTerm
 * 1    MCLR / Vpp                      Programaci�n/Debug/Reset
 * 2    RA0                 out         Led Status
 * 3    RA1                 out         Led Modo
 * 4    RB0/PGED1                       SPI_SDO -> MOSI / Programacion/Debug
 * 5    RB1/PGEC1                       SPI_SDI -> MISO / Programacion/Debug
 * 6    RB2/AN4             in          IO4
 * 7    RB3/AN11            in          IO3
 * 8    Vss                             Vss
 * 9    RA2/RP3/AN5         out         SPI_SCK -> CLK
 * 10   RA3/RP4             UART2       Tx
 * 11   RB4/RP5             in          IO2
 * 12   RA4/RP6             out         Led Aux
 * 13   Vdd                             +3v3
 * 14   RB5                 in          IO1
 * 15   RB6                 out         SPI_CS -> /CS
 * 16   RB7                 in          IO5
 * 17   RB8/SCK1            in          IO6
 * 18   RB9/SDO1            out         OUT1
 * 19   RC9                 out         OUT2
 * 20   VCap                            Cap 100n + 10uF
 * 21   RB10/RP17           out         OUT3
 * 22   RB11/RP18           out         OUT4
 * 23   RB12/RP12           
 * 24   RB13/RP13           out/oc      RESET -> ESP-WROOM-02_Reset-pin15
 * 25   RB14/RP19           UART1       Tx    -> ESP-WROOM-02_Rx-pin11
 * 26   RB15/RP10           UART1       Rx    -> ESP-WROOM-02_Tx-pin12
 * 27   AVss                            Vss
 * 28   AVdd                            +3v3
 *
 * ****************************************************************************/

/**
  Section: Included Files
*/
#include <string.h>
#include <stdio.h>
#include <sys/time.h>

#include "mcc_generated_files/pin_manager.h"
#include "mcc_generated_files/system.h"
#include "mcc_generated_files/watchdog.h"
#include "config.h"
#include "adc.h"
#include "http.h"
#include "wifi.h"
#include "control.h"
#include "wiegand.h"
#include "clog.h"

#include "sd/fsio.h"
#include "flash/plib_nvm.h"

bool main_flag_core_timer;

void LedControl( void )
{
    static char led_count = 0;
    static char led_aux_count = 0;
    
    if(led_aux_count)
    {
        LED_Aux_SetHigh();
        led_aux_count--;
        if(led_aux_count == 0)
        {
            LED_Aux_SetLow();
        }
    }
    
    if(++led_count > 20)
    {
        LED_Status_SetLow();
        LED_Modo_SetLow();
        led_count = 0;
    }
    
    if(g_wifi_info.status.wifi_ok)
    {
        if(led_count > 10)
        {
            if(g_wifi_info.status.wifi_conectado_ap)
            {
                if((led_count-10) <= (g_wifi_info.status.wifi_conectado_ap*2))
                {
                    LED_Status_SetValue(led_count & 0x01);
                }
            }
            else
            {
                LED_Status_SetLow();
            }
        }
        else
        {
            LED_Status_SetLow();
        }

        if(g_wifi_info.status.wifi_mode)
        {
            if(led_count <= (g_wifi_info.status.wifi_mode*2))
            {
                LED_Modo_SetValue(led_count & 0x01);
            }
        }
        else
        {
            LED_Modo_SetLow();
        }

        if(g_wifi_info.status.host_conectado)
        {
            LED_Aux_SetValue(led_count & 0x02);
        }
        else
        {
            LED_Aux_SetLow();
        }
    }
    else
    {
        LED_Status_SetValue((led_count) & 0x04);
        LED_Modo_SetValue((led_count+1) & 0x04);
        LED_Aux_SetValue((led_count+2) & 0x04);
    }
    
}
/*
                         Main application
 */
int main(void)
{
    main_flag_core_timer = false;
    g_wifi_info.status.flag_sd_ok = false;
    g_wifi_info.status.count_inactividad = 0;

    ConfigInit();
    SYSTEM_Initialize();
    LogInit();

    LogMessage("[MAIN] ****************************************");
    LogMessage("[MAIN] Dom32-IO-WiFi.");
    LogMessage("[MAIN] Compilacion " __DATE__ " " __TIME__ ".");
    LogMessage("[MAIN] Compilador " __VERSION__ ".");
    LogMessage("[MAIN] Procesador PIC32MM256GPM028.");

    NVM_Initialize();
    if( !FSInit())
    {
        LogMessage("[MAIN] Error de tarjeta SD.");
    }
    else
    {
        LogMessage("[MAIN] Tarjeta SD Ok.");
        g_wifi_info.status.flag_sd_ok = true;
    }
    
    ConfigLoad();

    ADCInit();
    CTRLInit();
    WiFiInit();
    HTTPInit();
    WGND_Init();
    
    strncpy(g_wifi_info.status.up_fw, __DATE__ " " __TIME__, 
            sizeof(g_wifi_info.status.up_fw)-1);

    LogMessage("[MAIN] ********** Init Ok **********");
    
    while(1)
    {
        WATCHDOG_TimerClear();

        WiFiTask();
        HTTPTask();
        CTRLTask();
        ADCTask();
        
        if(main_flag_core_timer)
        {
            main_flag_core_timer = false;
            /* Timer 10 veces por segundo - 100ms */
            if(g_wifi_info.status.count_inactividad & 0x02) LedControl();
            ConfigTimer();
            ADCTimer();
            WiFiTimer();
            HTTPTimer();
            CTRLTimer();
            if(g_wifi_info.f.config.enable_wiegand) WGND_Timer();
            g_wifi_info.status.count_inactividad++;
            if(g_wifi_info.status.count_inactividad == 36000)
            {
                /* una hora */
                LogMessage("[MAIN] RESET por inactividad.");
                CTRLReset(0);
            }
        }
    }
    return 1; 
}
/**
 End of File
*/
