wpirri/dom32-io-wifi/Programa-2/src/control.c

/***************************************************************************
    Copyright (C) 2026   Walter Pirri

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
    You should have received a copy of the GNU Lesser General Public
    License along with this library; if not, write to the Free Software
    Foundation, Inc., 59 Temple Place, Suite 330, Boston, MA  02111-1307  USA
 ***************************************************************************/
#include "control.h"

#include <xc.h>

#include <stdio.h>
#include <stdlib.h>
#include <string.h>
#include <stdbool.h>

#include "defines.h"
#include "log.h"
#include "sd/fsio.h"
#include "config.h"
#include "rtcc.h"
#include "wifi/wifi.h"
#include "misc/strfunc.h"
#include "misc/beep.h"
#include "http.h"
#include "system.h"
#include "rtcc.h"

#include "adc.h"
#include "io.h"
#include "wiegand.h"

#define _DEBUG_MSG

/* **** WiFi *************************************************************** */
typedef enum
{
    WIFI_INIT = 0,
    WIFI_MODO_AP,
    WIFI_MODO_AP_OK,
    WIFI_MODO_ST,
    WIFI_MODO_ST_OK,
    WIFI_CONECTAR_A_HOST,
    WIFI_CONECTADO_A_HOST,
    WIFI_DESCONECTADO_DE_HOST,
    WIFI_ERROR,
    WIFI_ERROR_FATAL,
    WIFI_ERROR_FATAL_LOOP
} enum_control_wifi_stm;

enum_control_wifi_stm control_wifi_stm;
unsigned int control_wifi_stm_delay;
char g_control_c_wiegand_card_code[17];

/* **** Control ************************************************************ */
bool status_sd_ok;
bool assinc_timer_flag;
bool start_in_ap_mode;	/* Solo para I/O */
unsigned int wifi_config_timer_count;
unsigned int keep_alive_timer_count;
unsigned int reset_timer_count;
unsigned int update_firmware_timer_count;
unsigned int save_config_timer_count;
unsigned int control_file_flags;
char filename_to_download[256];
unsigned int download_list_count;
const char fecha_compilacion[] = __DATE__ " " __TIME__;
const char version_compilador[] = __VERSION__;

void DownloadFile(const char* filename);
void ControlHostKeepAlive(void);
void ControlFileFlags( void );
void ProcesarDownloadList( void );

void ControlInit( bool sd_ok )
{
    status_sd_ok = sd_ok;
    filename_to_download[0] = 0;
    keep_alive_timer_count = 0;
    reset_timer_count = 0;
    update_firmware_timer_count = 0;
    save_config_timer_count = 0;
    assinc_timer_flag = false;
    control_file_flags = 6000;
    download_list_count = 0;
    
    /* **** WiFi *********************************************************** */
    control_wifi_stm = WIFI_INIT;
    control_wifi_stm_delay = 500;
    wifi_config_timer_count = 0;
    
    /* **** I/O ************************************************************ */
    start_in_ap_mode = false;
    if(g_wifi_config.u.config.wifi_ap1[0] == 0 && g_wifi_config.u.config.wifi_ap2[0] == 0)
    {
        g_wifi_config.u.config.start_config_mode = 1;
    }
    if(g_wifi_config.u.config.start_config_mode)
    {
        start_in_ap_mode = true;
    }
    g_wifi_config.u.config.start_config_mode = 1;
    /* **** I/O ************************************************************ */

    save_config_timer_count = 1;
}

const char* ControlVersion( void )
{
    return (const char*)&fecha_compilacion[0];
}

const char* ControlCompilador( void )
{
    return (const char*)&version_compilador[0];
}

/*
    Se llama 100 veces por segundo
 */
void ControlTimer( void )
{
    /* Para las cosas que necesitan el timer pero no pueden estar dentro de una int */
    assinc_timer_flag = true;
    
    if(control_wifi_stm_delay) control_wifi_stm_delay--;
    if(wifi_config_timer_count) wifi_config_timer_count--;
    if(WiFiConectado() && keep_alive_timer_count) keep_alive_timer_count--;
    if(control_file_flags) control_file_flags--;
}

void ControlTask(void)
{
    if(WiFiConectado() && keep_alive_timer_count == 0)
    {
        ControlHostKeepAlive();
    }
    
    if(control_file_flags == 0)
    {
        control_file_flags = 1000;
        if(HttpOnLine())
        {
            ControlFileFlags();
        }
    }
    
    /* Para las cosas que dependen del timer pero no pueden estar en una interrupcion */
    if(assinc_timer_flag)
    {
        assinc_timer_flag = false;
        
        if(save_config_timer_count)
        {
            save_config_timer_count--;
            if(save_config_timer_count == 0)
            {
                ConfigSave();
            }

        }

        if(update_firmware_timer_count)
        {
            update_firmware_timer_count--;
            if(update_firmware_timer_count == 0)
            {

                DownloadFile("/download/"FIRMWARE_FILENAME);
            }
        }
        
        if(reset_timer_count)
        {
            reset_timer_count--;
            if(reset_timer_count == 0)
            {
                if(save_config_timer_count)
                {
                    LogMessage("[ControlTask] Graban configuracion pendiente, se reprograma el RESET");
                    ControlSystemReset(save_config_timer_count * 2);
                }
                else
                {
                    SystemReset();
                }
            }
        }
        
        IOTimer();
        
        if(g_wifi_config.u.config.enable_wiegand) WGND_Timer();
        
        ADCTimer();
    }
    
    if(filename_to_download[0])
    {
        LogMessage("[ControlTask] Download: [%s]", filename_to_download);


        DownloadFile(filename_to_download);
        filename_to_download[0] = 0;
    }
    
}

void ControlSaveConfig(int t)
{
    save_config_timer_count = t;
}

void ControlSystemReset(int t)
{
    reset_timer_count = t;
    LogMessage("[ControlSystemReset] RESET en %i segundos", reset_timer_count/100);
}

void DownloadFile(const char* filename)
{
    HttpDownload(filename);
}

void ControlHostKeepAlive(void)
{
    char url[256];
    char data[1024];
    int rc;
    char resp_err_code[16];
    char resp_err_msg[256];
    int i;
    
    sprintf(url, "%s/infoio", g_wifi_config.u.config.rqst_path);
    sprintf(data, "ID=%s&TYP=%s&FW=%s&AT=%s&SDK=%s", 
            WiFiMAC(), WIFI_HW_Name, ControlVersion(), WiFiAT(), WiFiSDK());

	/* Agrego el estadop de la I/O */
	strcat(data, IOGetStatus());
    
    /* Agrego la tarjeta */
    if(strlen(g_control_c_wiegand_card_code))
    {
        strcat(data, "&CARD=");
        strcat(data, g_control_c_wiegand_card_code);
    }
    
    /* Solicito configuración inicial */
    if(g_wifi_config.u.config.io_config_default)
    {
        strcat(data, "&UPDATEIO=1");
    }
    
    /* Agrego mi estado */
    if(HttpOnLine() == 0)
    {
        strcat(data, "&OFFLINE=1");
    }
    
    rc = HttpQueryHost(url, data, NULL, data);
    if(rc == 200)
    {
#ifdef DEBUG_MSG
        LogMessage("[ControlHostKeepAlive] HTTP Req Ok");
#endif
        /* Borro la tarjeta al recibir HTTP 200 para evitar bucle infinito de reintentos */
        g_control_c_wiegand_card_code[0] = 0;
        /* Si la respuesta vino entre [""] le hago limpieza */
        if(data[0] == '[' && data[1] == '\"')
        {
            for(i = 2; data[i]; i++)
            {
                data[i-2] = data[i];
            }
            data[i-4] = 0;
        }

        if(HTTPGetFormData(data, "error", resp_err_code))
        {
            if(HTTPGetFormData(data, "message", resp_err_msg))
            {
                if(atoi(resp_err_code) == 0)
                {
#ifdef DEBUG_MSG
                    LogMessage("[ControlHostKeepAlive] Respuesta del sistema Ok");
#endif
                    HttpConexionOk();
                    /* Busco configuraciones, comandos, etc */
                    ProcessGeneralConfig(data);
                    keep_alive_timer_count = g_wifi_config.u.config.report;
                    
                    /* **** I/O **** */
                    if(g_wifi_config.u.config.start_config_mode)
                    {
                        g_wifi_config.u.config.start_config_mode = 0;
                        save_config_timer_count = 1;
                    }
                    /* Borro la tarjeta si había */
                    g_control_c_wiegand_card_code[0] = 0;
                    /* **** I/O **** */
                    
                    return;
                }
#ifdef DEBUG_MSG
                else
                {
                    LogMessage("[ControlHostKeepAlive] Respuesta del sistema [error = %s message = %s]", resp_err_code, resp_err_msg );
                }
#endif
            }
        }
    }
#ifdef DEBUG_MSG
    else
    {
        LogMessage("[ControlHostKeepAlive] HTTP Req No Ok [%i]", rc);
    }
#endif
    HttpConexionError();
    
    keep_alive_timer_count = (g_wifi_config.u.config.report > 500)?500:g_wifi_config.u.config.report;
}

void ProcessGeneralConfig(char* in)
{
    char s[256];
    struct tm tm_time;
    char *p;
    
#ifdef DEBUG_MSG
    LogMessage("[ProcessGeneralConfig] [%s]", in);
#endif
    
    if(HTTPGetFormData(in, "ap1", g_wifi_config.u.config.wifi_ap1))
    {
        save_config_timer_count = 100;
    }
    if(HTTPGetFormData(in, "ap1p", g_wifi_config.u.config.wifi_ap1_pass))
    {
        save_config_timer_count = 100;
    }
    if(HTTPGetFormData(in, "ap2", g_wifi_config.u.config.wifi_ap2))
    {
        save_config_timer_count = 100;
    }
    if(HTTPGetFormData(in, "ap2p", g_wifi_config.u.config.wifi_ap2_pass))
    {
        save_config_timer_count = 100;
    }
    if(HTTPGetFormData(in, "ce1", g_wifi_config.u.config.wifi_host1))
    {
        p = strchr(g_wifi_config.u.config.wifi_host1, ':');
        if(p)
        {
            *p = 0;
            p++;
            /* viene con el port */
            g_wifi_config.u.config.wifi_host1_port = atoi(p);
        }
        save_config_timer_count = 100;
    }
    if(HTTPGetFormData(in, "ce2", g_wifi_config.u.config.wifi_host2))
    {
        p = strchr(g_wifi_config.u.config.wifi_host2, ':');
        if(p)
        {
            *p = 0;
            p++;
            /* viene con el port */
            g_wifi_config.u.config.wifi_host2_port = atoi(p);
        }
        save_config_timer_count = 100;
    }
    if(HTTPGetFormData(in, "path", g_wifi_config.u.config.rqst_path))
    {
        save_config_timer_count = 100;
    }
    if(HTTPGetFormData(in, "ce1p", s))
    {
        g_wifi_config.u.config.wifi_host1_port = atoi(s);
        save_config_timer_count = 100;
    }
    if(HTTPGetFormData(in, "ce2p", s))
    {
        g_wifi_config.u.config.wifi_host2_port = atoi(s);
        save_config_timer_count = 100;
    }
    if(HTTPGetFormData(in, "rep", s))
    {
        g_wifi_config.u.config.report = atoi(s) * 100;
        if(g_wifi_config.u.config.report == 0)
        {
            g_wifi_config.u.config.report = 500;
        }
        save_config_timer_count = 100;
    }

    if(HTTPGetFormData(in, "reset", s))
    {
        ControlSystemReset(300);
    }
    if(HTTPGetFormData(in, "update", s))
    {
        if( !strcmp(s, "firmware"))
        {
            update_firmware_timer_count = 100;
        }
    }

    if(HTTPGetFormData(in, "time", s))
    {
        LogMessage("TIME: %s", s);
        /*             1111111111
         *   01234567890123456789
         tmp YYYY/MM/DD hh:mm:ss
         */
        if(s[4] == '/' && s[7] == '/' && s[10] == ' ' && 
                s[13] == ':' && s[16] == ':')
        {
            s[4] = 0;
            s[7] = 0;
            s[10] = 0;
            s[13] = 0;
            s[16] = 0;
            s[19] = 0;
            
            tm_time.tm_year = atoi(&s[0]) - 1900;
            tm_time.tm_mon = atoi(&s[5]) - 1;
            tm_time.tm_mday = atoi(&s[8]);
            tm_time.tm_hour = atoi(&s[11]);
            tm_time.tm_min = atoi(&s[14]);
            tm_time.tm_sec = atoi(&s[17]);

            RTCC_TimeSet(&tm_time);
        }
        else
        {
            LogMessage("[CTRLConfSys] Error de formato para TIME");
        }
    }
    if(HTTPGetFormData(in, "download", s))
    {
        strcpy(filename_to_download, s);
    }
    
    /* **** Control de I/O ************************************************* */
    IOSetConfig(in);
    IOSetStatus(in);
    /* **** Control de I/O ************************************************* */
    
}

void ControlFileFlags( void )
{
    FSFILE *f;
    
    f = FSfopen(FIRMWARE_FILENAME, FS_READ);
    if(f)
    {
        FSfclose(f);
        LogMessage("[ControlFileFlags] Se encontro un nuevo firmware");
        ControlSystemReset(300);
        return;
    }
    
    if(filename_to_download[0] == 0)
    {
        f = FSfopen(DOWNLOAD_LIST_FILENAME, FS_READ);
        if(f)
        {
            FSfclose(f);
            ProcesarDownloadList();
            control_file_flags = 100;
            return;
        }
    }    
    
}

void ProcesarDownloadList( void )
{
    FSFILE *f;
    int rc;
    char line[256];
    unsigned int line_len;
    unsigned int line_count = 0;
    
    f = FSfopen(DOWNLOAD_LIST_FILENAME, FS_READ);
    if(f)
    {
        do {
            /* Leo una linea */
            line_len = 0;
            do {
                rc = FSfread(&line[line_len++], 1, 1, f);
            } while(line[line_len-1] != 0x0d && line[line_len-1] != 0x0a && line_len < 256 && rc == 1);
            line[--line_len] = 0;
            if(line_len > 0 && line[0] != '#')
            {
                /* Analizo la linea */
                if(line_count == download_list_count)
                {
                    if(strchr(line, '\r')) *(strchr(line, '\r')) = 0;
                    if(strchr(line, '\n')) *(strchr(line, '\n')) = 0;
                    
                    strcpy(filename_to_download, line);
                    
                    download_list_count++;
                    break;
                }
                line_count++;
            }
        } while(rc == 1);
        FSfclose(f);
        if(rc == 0)
        {
            /* Fin de archivo */
            download_list_count = 0;
            FSremove(DOWNLOAD_LIST_FILENAME);
        }
    }
}

/* **** WiFi *************************************************************** */
void Control_WiFi_Task(void)
{
    WiFiCheckUnsol();
    
    if(control_wifi_stm_delay)return;

    switch(control_wifi_stm)
    {
        case WIFI_INIT:
            if(WiFiStart() == 0)
            {
                /* Modo inicial del dispositivo */
                if(start_in_ap_mode)
                {
                    control_wifi_stm = WIFI_MODO_AP;
                }
                else
                {
                    control_wifi_stm = WIFI_MODO_ST;
                }
            }
            else
            {
                control_wifi_stm_delay = 500;
            }
            break;
        case WIFI_MODO_AP:
            if(WiFiSetMode(WIFI_MODE_AP) == 0)
            {
                control_wifi_stm++;
                wifi_config_timer_count = 6000;
            }
            else
            {
                control_wifi_stm = WIFI_ERROR;
            }
            break;
        case WIFI_MODO_AP_OK:
            if(wifi_config_timer_count == 0)
            {
                control_wifi_stm = WIFI_MODO_ST;
            }
            if(WiFiStaConectado())
            {
                wifi_config_timer_count = 250;
            }
            break;
        case WIFI_MODO_ST:
            if(WiFiSetMode(WIFI_MODE_ST) == 0)
            {
                control_wifi_stm++;
            }
            else
            {
                control_wifi_stm = WIFI_ERROR;
            }
            break;
        case WIFI_MODO_ST_OK:
            if(WiFiConectado() > 0)
            {
                control_wifi_stm++;
            }
            else
            {
                WiFiSwitchRouter();
                control_wifi_stm_delay = 500;
                control_wifi_stm = WIFI_MODO_ST;
            }
            break;
        case WIFI_CONECTAR_A_HOST:
            break;
        case WIFI_CONECTADO_A_HOST:
            break;
        case WIFI_DESCONECTADO_DE_HOST:
            break;
        case WIFI_ERROR:
            break;
        case WIFI_ERROR_FATAL:
            break;
        case WIFI_ERROR_FATAL_LOOP:
            break;
        default:
            break;
    }    
}

void ControlNotificarTarjeta(const char* code)
{
    strcpy(g_control_c_wiegand_card_code, code);
}
