wpirri/dom32-io-wifi/Programa-2/src/io.c

/***************************************************************************
    Copyright (C) 2024   Walter Pirri

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
    You should have received a copy of the GNU Lesser General Public
    License along with this library; if not, write to the Free Software
    Foundation, Inc., 59 Temple Place, Suite 330, Boston, MA  02111-1307  USA
***************************************************************************/
#include "io.h"

#include <xc.h>

#include <stdio.h>
#include <stdlib.h>
#include <string.h>
#include <stdarg.h>
#include <stdbool.h>

#include "defines.h"
#include "log.h"
#include "config.h"
#include "control.h"
#include "adc.h"
#include "wifi/wifi.h"
#include "http.h"
#include "wiegand.h"

int g_io_status[6];
int g_io_pulse_count[6];
int g_out_status[4];
int g_out_pulse_count[4];
char g_buffer_io_status[1024];

void IOInit( void )
{
    /* LED_Azul - A0 */
    TRISACLR = (1 << 0);
    /* LED_Verde - A1 */
    TRISACLR = (1 << 1);
    /* LED_Ambar - A4 */
    TRISACLR = (1 << 4);
    
    /* OUT1 - B9 */
    TRISBCLR = (1 << 9);
    /* OUT2 - C9 */
    TRISCCLR = (1 << 9);
    /* OUT3 - B10 */
    TRISBCLR = (1 << 10);
    /* OUT4 */
    TRISBCLR = (1 << 11);
    
    g_io_status[0] = (-1);
    g_io_status[1] = (-1);
    g_io_status[2] = (-1);
    g_io_status[3] = (-1);
    g_io_status[4] = (-1);
    g_io_status[5] = (-1);
    
    g_io_pulse_count[0] = 0;
    g_io_pulse_count[1] = 0;
    g_io_pulse_count[2] = 0;
    g_io_pulse_count[3] = 0;
    g_io_pulse_count[4] = 0;
    g_io_pulse_count[5] = 0;

    g_out_status[0] = (-1);
    g_out_status[1] = (-1);
    g_out_status[2] = (-1);
    g_out_status[3] = (-1);
    
    g_out_pulse_count[0] = 0;
    g_out_pulse_count[1] = 0;
    g_out_pulse_count[2] = 0;
    g_out_pulse_count[3] = 0;
    
}

const char* IOGetStatus( void )
{
    char change[256];
    
    g_buffer_io_status[0] = 0;
    change[0] = 0;
    
    if(g_wifi_config.u.config.io_config_values[0] == 'i' || g_wifi_config.u.config.io_config_values[0] == 'o')
    {
        if(IO1_GetValue())
        {
            strcat(g_buffer_io_status, "&IO1=1");
            if( g_io_status[0] != 1 )
            {
                if(g_io_status[0] != (-1)) strcat(change, "IO1,");
                g_io_status[0] = 1;
            }
        }
        else
        {
            strcat(g_buffer_io_status, "&IO1=0");
            if( g_io_status[0] != 0 )
            {
                if(g_io_status[0] != (-1)) strcat(change, "IO1,");
                g_io_status[0] = 0;
            }
        }
    }

    if(g_wifi_config.u.config.io_config_values[1] == 'i' || g_wifi_config.u.config.io_config_values[1] == 'o')
    {
        if(IO2_GetValue())
        {
            strcat(g_buffer_io_status, "&IO2=1");
            if( g_io_status[1] != 1 )
            {
                if(g_io_status[1] != (-1)) strcat(change, "IO2,");
                g_io_status[1] = 1;
            }
        }
        else
        {
            strcat(g_buffer_io_status, "&IO2=0");
            if( g_io_status[1] != 0 )
            {
                if(g_io_status[1] != (-1)) strcat(change, "IO2,");
                g_io_status[1] = 0;
            }
        }
    }

    /*
     IO3 - Digital o Analogica
     */
    if(g_wifi_config.u.config.io_config_values[2] == 'i' || g_wifi_config.u.config.io_config_values[2] == 'o')
    {
        if(IO3_GetValue())
        {
            strcat(g_buffer_io_status, "&IO3=1");
            if( g_io_status[2] != 1 )
            {
                if(g_io_status[2] != (-1)) strcat(change, "IO3,");
                g_io_status[2] = 1;
            }
        }
        else
        {
            strcat(g_buffer_io_status, "&IO3=0");
            if( g_io_status[2] != 0 )
            {
                if(g_io_status[2] != (-1)) strcat(change, "IO3,");
                g_io_status[2] = 0;
            }
        }
    }
    else if(g_wifi_config.u.config.io_config_values[2] == 'a')
    {
        sprintf(&g_buffer_io_status[strlen(g_buffer_io_status)], "&IO3=%i", ADCGet(1));
    }
    
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
            g_out_status[2] = 1;
        }
    }
    else
    {
        strcat(g_buffer_io_status, "&OUT3=0");
        if( g_out_status[2] != 0 )
        {
            if(g_out_status[2] != (-1)) strcat(change, "OUT3,");
            g_out_status[2] = 0;
        }
    }
    
    if(OUT4_GetValue())
    {
        strcat(g_buffer_io_status, "&OUT4=1");
        if( g_out_status[3] != 1 )
        {
            if(g_out_status[3] != (-1)) strcat(change, "OUT4,");
            g_out_status[3] = 1;
        }
    }
    else
    {
        strcat(g_buffer_io_status, "&OUT4=0");
        if( g_out_status[3] != 0 )
        {
            if(g_out_status[3] != (-1)) strcat(change, "OUT4,");
            g_out_status[3] = 0;
        }
    }
    
    /* Me fijo si hubo cambios y los agrego al buffer */
    if(strlen(change))
    {
        strcat(g_buffer_io_status, "&CHG=");
        strcat(g_buffer_io_status, change);
        /* saco la coma del final */
        g_buffer_io_status[strlen(g_buffer_io_status)-1] = 0;
    }

    return (const char*)(&g_buffer_io_status[0]);
}

void IOSetConfig( const char* msg )
{
    char s[256];
    int save_config = 0;
    int reset_system = 0;

    if(msg)
    {
        if(HTTPGetFormData(msg, "wiegand", s))
        {
            if(s[0] == '1')
            {
                if(g_wifi_config.u.config.enable_wiegand == 0)
                {
                    g_wifi_config.u.config.io_config_values[4] = 'i';
                    g_wifi_config.u.config.io_config_values[5] = 'i';
                    save_config = 1;
                    reset_system = 1;
                }
                g_wifi_config.u.config.enable_wiegand = 1;
            }
            else
            {
                if(g_wifi_config.u.config.enable_wiegand == 1)
                {
                    save_config = 1;
                    reset_system = 1;
                }
                g_wifi_config.u.config.enable_wiegand = 0;
            }
        }

        if(HTTPGetFormData(msg, "cfgIO1", s))
        {
            /* Entrada 1 - RB5 */
            if(s[0] == 'i')
            {
                g_wifi_config.u.config.io_config_values[0] = s[0];
                TRISBbits.TRISB5 = 1;
                CNPUBbits.CNPUB5 = 1;
            }
            else if(s[0] == 'o')
            {
                g_wifi_config.u.config.io_config_values[0] = s[0];
                TRISBbits.TRISB5 = 0;
                CNPUBbits.CNPUB5 = 0;
            }
            save_config = 1;
        }
        if(HTTPGetFormData(msg, "cfgIO2", s))
        {
            /* Entrada 2 - RB4 */
            if(s[0] == 'i')
            {
                g_wifi_config.u.config.io_config_values[1] = s[0];
                TRISBbits.TRISB4 = 1;
                CNPUBbits.CNPUB4 = 1;
            }
            else if(s[0] == 'o')
            {
                g_wifi_config.u.config.io_config_values[1] = s[0];
                TRISBbits.TRISB4 = 0;
                CNPUBbits.CNPUB4 = 0;
            }
            save_config = 1;
        }
        if(HTTPGetFormData(msg, "cfgIO3", s))
        {
            /* Entrada 3 - RB3 / AN11 */
            if(s[0] == 'i')
            {
                g_wifi_config.u.config.io_config_values[2] = s[0];
                TRISBbits.TRISB3 = 1;
                ANSELBbits.ANSB3 = 0;   // AN11
                CNPUBbits.CNPUB3 = 1;
            }
            else if(s[0] == 'o')
            {
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
            ANSELBbits.ANSB3 = 0;   // AN11
            CNPUBbits.CNPUB3 = 0;
        }
        else if(g_wifi_config.u.config.io_config_values[2] == 'a')
        {
            TRISBbits.TRISB3 = 1;
            ANSELBbits.ANSB3 = 1;   // AN11
            CNPUBbits.CNPUB3 = 0;
        }

        /* Entrada 4 - RB2 / AN4*/
        if(g_wifi_config.u.config.io_config_values[3] == 'i')
        {
            TRISBbits.TRISB2 = 1;
            ANSELBbits.ANSB2 = 0;   // AN4
            CNPUBbits.CNPUB2 = 1;
        }
        else if(g_wifi_config.u.config.io_config_values[3] == 'o')
        {
            TRISBbits.TRISB2 = 0;
            ANSELBbits.ANSB2 = 0;   // AN4
            CNPUBbits.CNPUB2 = 0;
        }
        else if(g_wifi_config.u.config.io_config_values[3] == 'a')
        {
            TRISBbits.TRISB2 = 1;
            ANSELBbits.ANSB2 = 1;   // AN4
            CNPUBbits.CNPUB2 = 0;
        }

        if(g_wifi_config.u.config.enable_wiegand == 0)
        {
            //Disable CNBI interrupt
            IEC0bits.CNBIE = 0;

            /* Entrada 5 - RB7 */
            if(g_wifi_config.u.config.io_config_values[4] == 'i')
            {
                TRISBbits.TRISB7 = 1;
                CNPUBbits.CNPUB7 = 1;
            }
            else if(g_wifi_config.u.config.io_config_values[4] == 'o')
            {
                TRISBbits.TRISB7 = 0;
                CNPUBbits.CNPUB7 = 0;
            }

            /* Entrada 6 - RB8 */
            if(g_wifi_config.u.config.io_config_values[5] == 'i')
            {
                TRISBbits.TRISB8 = 1;
                CNPUBbits.CNPUB8 = 1;
            }
            else if(g_wifi_config.u.config.io_config_values[5] == 'o')
            {
                TRISBbits.TRISB8 = 0;
                CNPUBbits.CNPUB8 = 0;
            }
        }
    }

    if(save_config)
    {
        g_wifi_config.u.config.io_config_default = 0;
        ControlSaveConfig(100);
    }
    
    if(reset_system)
    {
        ControlSystemReset(150);
    }
    
}

void IOSetStatus( const char* msg )
{
    char s[256];

    if(HTTPGetFormData(msg, "IO1", s) && 
            g_wifi_config.u.config.io_config_values[0] == 'o')
    {
        if(atoi(s) > 1)
        {
            g_io_pulse_count[0] = (atoi(s)-1)*100;
            IO1_SetHigh();
        } else if(atoi(s) == 1)
        {
            IO1_SetHigh();
        }
        else
        {
            IO1_SetLow();
        }
    }
    if(HTTPGetFormData(msg, "IO2", s) && 
            g_wifi_config.u.config.io_config_values[1] == 'o')
    {
        if(atoi(s) > 1)
        {
            g_io_pulse_count[1] = (atoi(s)-1)*100;
            IO2_SetHigh();
        } else if(atoi(s) == 1)
        {
            IO2_SetHigh();
        }
        else
        {
            IO2_SetLow();
        }
    }
    if(HTTPGetFormData(msg, "IO3", s) && 
            g_wifi_config.u.config.io_config_values[2] == 'o')
    {
        if(atoi(s) > 1)
        {
            g_io_pulse_count[2] = (atoi(s)-1)*100;
            IO3_SetHigh();
        } else if(atoi(s) == 1)
        {
            IO3_SetHigh();
        }
        else
        {
            IO3_SetLow();
        }
    }
    if(HTTPGetFormData(msg, "IO4", s) && 
            g_wifi_config.u.config.io_config_values[3] == 'o')
    {
        if(atoi(s) > 1)
        {
            g_io_pulse_count[3] = (atoi(s)-1)*100;
            IO4_SetHigh();
        } else if(atoi(s) == 1)
        {
            IO4_SetHigh();
        }
        else
        {
            IO4_SetLow();
        }
    }
    /*
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
    {
        g_out_pulse_count[2]--;
        if(g_out_pulse_count[2] == 0)
        {
            OUT3_SetLow();
        }
    }
    if(g_out_pulse_count[3] > 0)
    {
        g_out_pulse_count[3]--;
        if(g_out_pulse_count[3] == 0)
        {
            OUT4_SetLow();
        }
    }

}
