wpirri/dom32-io-wifi/Programa/http.c

/***************************************************************************
    Copyright (C) 2020   Walter Pirri

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
    You should have received a copy of the GNU Lesser General Public
    License along with this library; if not, write to the Free Software
    Foundation, Inc., 59 Temple Place, Suite 330, Boston, MA  02111-1307  USA
 ***************************************************************************/
#define _IN_HTTP_C_
#include "http.h"
#undef _IN_HTTP_C_

#include <string.h>
#include <stdlib.h>
#include <stdio.h>

#include "mcc_generated_files/pin_manager.h"
#include "mcc_generated_files/system.h"
#include "mcc_generated_files/watchdog.h"

#include "control.h"
#include "wifi.h"
#include "config.h"
#include "clog.h"
#include "sd/fsio.h"

#define DOWNLOAD_TEMP_FILE_NAME "download.tmp"

const char xml_200[] =      "HTTP/1.1 200 OK\r\nConnection: close\r\n"
                            "Content-Type: text/xml\r\n\r\n";
const char http_200[] =     "HTTP/1.1 200 OK\r\n"
                            "Connection: close\r\n"
                            "Content-Type: text/html\r\n"
                            "Cache-Control: no-cache\r\n\r\n";
const char http_404[] =     "HTTP/1.1 404 Not found\r\n"
                            "Connection: close\r\n\r\n"
                            "404: File not found\r\n";
/* POST
 * 1.- %s: URI
 * 2.- %s: Host
 * 3.- %d: Content-Length
 * 4.- %s: datos
 */
const char http_post[] =    "POST %s HTTP/1.1\r\n"
                            "Host: %s\r\n"
                            "Connection: keep-alive\r\n"
                            "Content-Length: %d\r\n"
                            "User-Agent: Dom32io/1.00 (Microchip;PIC32)\r\n"
                            "Accept: text/html,text/xml\r\n"
                            "Content-Type: application/x-www-form-urlencoded\r\n\r\n%s";
/*
 * GET
 * 1.- %s: URI
 * 2.- %s: Host
 */
const char http_get[] =     "GET %s HTTP/1.1\r\n"
                            "Host: %s\r\n"
                            "Connection: close\r\n"
                            "User-Agent: Dom32io/1.00 (Microchip;PIC32)\r\n"
                            "Accept: text/html,text/xml\r\n\r\n";

unsigned int http_process_tmp_file;
char http_process_tmp_file_to_name[FILE_NAME_SIZE+1];

unsigned int g_download_file_count;
unsigned int g_download_timer_count;

int HTTPGetFile(const char* filename, const char* params)
{
    char tmp_uri[MAX_HTTP_URI+1];
    char tmp_rqst[MAX_HTTP_DATA+1];

    if( !filename )
    {
        LogMessage("[HTTPGetFile] Error en archivo.");
        return (-1);
    }
    if( !g_wifi_info.status.flag_sd_ok)
    {
        LogMessage("[HTTPGetFile] Error en File System.");
        return (-1);
    }

    LogMessage("[HTTPGetFile] Solicitando archivo %s.", filename);
    g_wifi_info.status.control_notificar = 0;
    if(params)
    {
        snprintf(tmp_uri, MAX_HTTP_URI, "%s?%s", filename, params);
    }
    else
    {
        strncpy(tmp_uri, filename, MAX_HTTP_URI);
    }
    
    g_download_timer_count = 600;
    
    /*
     * GET
     * 1.- %s: URI
     * 2.- %s: Host
     */
    snprintf(tmp_rqst, MAX_HTTP_DATA, http_get,
             tmp_uri,
             g_wifi_host);
    if(HTTPAddOutput(tmp_uri, true, tmp_rqst, 250) <= 0)
    {
        /* No fue posible enviar */
        return 0;
    }
    return strlen(tmp_rqst);
}

int HTTPInitTmpFile(const char* buffer, int len)
{
    FSFILE* f;
    int rc = (-1);
    char s_content_length[16];

    if( !http_buffer_output.download)
    {
        LogMessage("[HTTPInitTmpFile] Download no iniciado.");
        return (-1);
    }
    
    if( !strstr(buffer, "200 OK"))
    {
        LogMessage("[HTTPInitTmpFile] Error en Download. Inicio No Ok.");
        http_buffer_output.download = 0;
        return (-1);
    }
    
    if(HTTPGetHeadData(buffer, "Content-Length", s_content_length))
    {
        http_buffer_input.download_length = atol(s_content_length);
    }
    else
    {
        http_buffer_input.download_length = 0;
    }

    LogMessage("[HTTPInitTmpFile] (%d bytes) -> %s", len, DOWNLOAD_TEMP_FILE_NAME);
    g_wifi_info.status.control_notificar = 0;
    http_buffer_input.download = 1;
    strcpy(http_buffer_input.filename, http_buffer_output.filename);
    
    f = FSfopen(DOWNLOAD_TEMP_FILE_NAME, FS_WRITE);
    if(f)
    {
        rc = FSfwrite(buffer, 1, len, f);
        FSfclose(f);
    }
    
    if(len < WIFI_READ_LINE_BUFFER_LEN)
    {
        /* Es un archivo chico */
        /* Procesar archivo temporal */
        http_process_tmp_file = 50;
        strncpy(http_process_tmp_file_to_name, http_buffer_input.filename, FILE_NAME_SIZE);
        g_end_download = true;
        
        http_buffer_input.download = 0;
    }
    
    http_buffer_output.download = 0;
    
    return rc;
}

int HTTPAddTmpFile(const char* buffer, int len)
{
    FSFILE* f;
    int rc = (-1);

    //LogMessage("[HTTPAddTmpFile] %-.20s (%d)", buffer, len);
    if( http_buffer_input.download == 0 )
    {
        LogMessage("[HTTPAddTmpFile] ERROR: Download no iniciado");
        return (-1);
    }
    
    //LogMessage("[HTTPAddTmpFile] (%d bytes) -> %s", len, DOWNLOAD_TEMP_FILE_NAME);
    g_wifi_info.status.control_notificar = 0;
    f = FSfopen(DOWNLOAD_TEMP_FILE_NAME, FS_APPEND);
    if(f)
    {
        rc = FSfwrite(buffer, 1, len, f);
        FSfclose(f);
    }
    return rc;
}

int HTTPEndTmpFile(const char* filename, const char* buffer, int len)
{
    int rc = 0;

    if( http_buffer_input.download == 0 )
    {
        LogMessage("[HTTPEndTmpFile] ERROR: Download no iniciado");
        return (-1);
    }

    if(len)
    {
        rc = HTTPAddTmpFile(buffer, len);
    }
    LogMessage("[HTTPEndTmpFile] %s", DOWNLOAD_TEMP_FILE_NAME);
    /* Procesar archivo temporal */
    http_process_tmp_file = 50;
    strncpy(http_process_tmp_file_to_name, filename, FILE_NAME_SIZE);
    g_end_download = true;
    return rc;
}

int ReadIPD(FSFILE *fs)
{
    char buffer[32];
    char *p;
    int buffer_len = 0;;
    int read_len;
    char*p_ipd_len;
    int ipd_len = 0;

    p = &buffer[0];
    while( (read_len = FSfread(p, 1, 1, fs) > 0) && (buffer_len < 32) )
    {
        buffer_len += 1;
        if(*p == ':')
        {
            /* Fin cabecera IPD */
            p += 1;
            break;
        }
        p += 1;
    }
    *p = 0;
    if(read_len <= 0) return (-1);

    p = &buffer[0];

    if( buffer[0] != '+' ||
        buffer[1] != 'I' ||
        buffer[2] != 'P' ||
        buffer[3] != 'D'  )  return (-1);

    /* Salteo la primer coma */
    while(*p != ',') { p++; buffer_len--; }
    p++; buffer_len--;
    /* Salteo la segunda coma coma */
    while(*p != ',') { p++; buffer_len--; }
    p++; buffer_len--;
    /*  */
    p_ipd_len = p;
    /* Voy hasta el fin de la cabecera +IPD */
    while(*p != ':') { p++; buffer_len--; }
    *p = 0;
    /* Tamaño de datos */
    ipd_len = atoi(p_ipd_len);

    return ipd_len;
}

int HttpHeadEnd(FSFILE *fs)
{
    char buffer[4];
    int read_len;
    int head_len;

    read_len = FSfread(buffer, 1, 4, fs);
    if(read_len != 4) return 0;
    head_len = 4;
    while(buffer[0] != 0x0d || buffer[1] != 0x0a || buffer[2] != 0x0d || buffer[3] != 0x0a)
    {
        buffer[0] = buffer[1];
        buffer[1] = buffer[2];
        buffer[2] = buffer[3];
        read_len = FSfread(&buffer[3], 1, 1, fs);
        head_len++;
        if(read_len != 1) return 0;
    }
    return head_len;
}

int HTTPProcessTmpFile(const char* tmpname, const char* filename, unsigned long filelength)
{
    char buffer[256];
    int len;
    int ipd_len;
    int head_len;
    FSFILE* fi;
    FSFILE* fo;
    unsigned long total_escrito = 0;
    int rc = (-1);

    LogMessage("[HTTPProcessTmpFile] %s -> %s", tmpname, filename);
    fi = FSfopen(tmpname, FS_READ);
    if(fi)
    {
        fo = FSfopen(filename, FS_WRITE);
        if(fo)
        {
            ipd_len = ReadIPD(fi);
            if( ipd_len > 0 )
            {
                head_len = HttpHeadEnd(fi);
                if(head_len)
                {
                    ipd_len -= head_len;
                    while(ipd_len > 0)
                    {
                        WATCHDOG_TimerClear();
                        len = FSfread(buffer, 1, (ipd_len>255)?255:ipd_len, fi);
                        if(len == 0) break;
                        FSfwrite(buffer, len, 1, fo);
                        ipd_len -= len;
                        total_escrito += len;
                        if(ipd_len == 0)
                        {
                            /* Leo el CR/LF del final */
                            FSfread(buffer, 1, 2, fi);
                            /* Parseo el proximo IPD */
                            ipd_len = ReadIPD(fi);
                        }
                    }
                }
            }
            FSfclose(fo);
            if(filelength != total_escrito)
            {
                LogMessage("[HTTPProcessTmpFile] %s recibido con Error", filename);
                rc = (-2);
            }
            else
            {
                LogMessage("[HTTPProcessTmpFile] %s recibido Ok", filename);
                rc = 0;
            }
        }
        else
        {
            LogMessage("[HTTPProcessTmpFile] Error abriendo archivo final %s", filename);
            rc = (-3);
        }
        FSfclose(fi);
    }
    else
    {
        LogMessage("[HTTPProcessTmpFile] Error abriendo archivo temporal %s", tmpname);
        rc = (-4);
    }
    return rc;
}

int Convert2CharToHex(const char* h)
{
    int h1, h2;
    
    if( (*h) >= '0' && (*h) <= '9' )
    {
        h1 = ((*h)-'0');
    }
    else if( (*h) >= 'A' && (*h) <= 'F' )
    {
        h1 = ((*h)-'A'+10);
    }
    else if( (*h) >= 'a' && (*h) <= 'f' )
    {
        h1 = ((*h)-'a'+10);
    }
    else
    {
        h1 = 0;
    }
    h++;
    if( (*h) >= '0' && (*h) <= '9' )
    {
        h2 = ((*h)-'0');
    }
    else if( (*h) >= 'A' && (*h) <= 'F' )
    {
        h2 = ((*h)-'A'+10);
    }
    else if( (*h) >= 'a' && (*h) <= 'f' )
    {
        h2 = ((*h)-'a'+10);
    }
    else
    {
        h2 = 0;
    }

    return ((h1*16)+h2);
}

int HttpDecodeFormData(char* out, const char* in, unsigned int max_out)
{
    int len = 0;
    
    LogMessage("HttpDecodeFormData");

    if(!in || !out) return (-1);
    
    while(*in)
    {
        if(*in == 0x25) /* % */
        {
            in++;
            *out = (unsigned char)Convert2CharToHex(in);
            in += 2;
        }
        else
        {
            *out = *in;
            in++;
        }
        out++;
        len++;
        if(len >= max_out) break;
    }
    *out = 0;
    return (len < max_out)?len:(-1);
}

int HttpGetRequest(const char *buffer, char *request, int max_len)
{
	int rc = 0;
    
    LogMessage("HttpGetRequest");
    
	while(*buffer && *buffer != '/') buffer++;
	if( !(*buffer)) return 0;
	while(*buffer && *buffer != ' ' && rc < max_len)
	{
		*request = *buffer;
		buffer++;
		request++;
		rc++;
	}
	*request = 0;
	return (rc < max_len)?rc:(-1);
}

int HTTPGetFormData(const char *buffer, const char *label, char *value)
{
    const char *p;
    int len = 0;
    
    p = buffer;
    do
    {
        p = strstr(p, label);
        if(p)
        {
            len = 0;
            p += strlen(label);
            if(*p == '=')
            {
                p++;
                while(*p && *p != '&')
                {
                    *value = *p;
                    p++;
                    value++;
                    len++;
                }
                *value = 0;
            }
        }
    } while(p);
    
    return len;
}

int HTTPGetHeadData(const char *buffer, const char *label, char *value)
{
    const char *p;
    int len = 0;
    
    p = strstr(buffer, label);
    if(p)
    {
        p += strlen(label);
        if(*p == ':')
        {
            p++;
            while(*p == ' ') p++;
            while(*p && *p != ' ' && *p != '\r' && *p != '\n')
            {
                *value = *p;
                p++;
                value++;
                len++;
            }
            *value = 0;
        }
    }
    return len;
}

int HTTPHeadResponse(const char *http_head)
{
    char str[4];
    char *p1;
    
    LogMessage("[HTTPHeadResponse] %-.20s", http_head); 

    if(http_head)
    {
        /* Busco el código de respuesta http en la cabecera
         * "HTTP/1.1 200 OK\r\n" */
        p1 = strchr(http_head, ' ');
        if(p1)
        {
            str[0] = *(++p1);
            str[1] = *(++p1);
            str[2] = *(++p1);
            str[3] = 0;
            return atoi(str);
        }
    }
    return 0;
}

int HTTPFormResponse(const char *http_data)
{
    char str[16];
    
    LogMessage("[HTTPFormResponse] %-.100s", http_data); 

    if(http_data)
    {
        if( strchr(http_data, '{') && 
            strchr(http_data, ':') && 
            strchr(http_data, ',') && 
            strchr(http_data, '}')  )
        {
            LogMessage("[HTTPFormResponse] Respuesta en formato JSON no esperada");
            return 99;
        }
        else if( strchr(http_data, '=') )
        {
            LogMessage("[HTTPFormResponse] Respuesta en formato de formulario");
            if(HTTPGetFormData((char*)http_data, "error", str))
            {
                LogMessage("[HTTPFormResponse] Respuesta con error: %s", str);
                return atoi(str);
            }
            else
            {
                /* Si no encuentra la leyenda error no hay error */
                return 0;
            }
        }
        else
        {
            /* Si no dice nada asumo no error */
            return 0;
        }
    }
    return (-1);
}

/*<html>
<head>
<title>Dom32IO</title>
</head>
<style>
body{background-color:grey;font-size:24pt;}
#it{height:75;font-size:24pt}
</style>
<body>
<form method="post">
<h1>WiFi</h1>
<hr />
<h2 >AP1:</h2>
&nbsp;<input id="it" type="text" name="ap1" value="%s">&nbsp;<input id="it" type="text" name="ap1p" value="%s"><br>
<h2 >AP2:</h2>
&nbsp;<input id="it" type="text" name="ap2" value="%s">&nbsp;<input id="it" type="text" name="ap2p" value="%s"><br>
<br>
<br>
&nbsp;&nbsp;<input id="it"  type="submit" value="Guardar">
</form>
</body>
</html>
*/
void HttpReturnWiFiFormConfig(char *out, int max_len)
{
    char wifi_host1[64];
    char wifi_host2[64];
    
    if(g_wifi_info.f.config.wifi_host1[0])
    {
        if(g_wifi_info.f.config.wifi_host1_port > 0)
        {
            sprintf(wifi_host1, "%s:%i", g_wifi_info.f.config.wifi_host1, g_wifi_info.f.config.wifi_host1_port);
        }
        else
        {
            strcpy(wifi_host1, g_wifi_info.f.config.wifi_host1);
        }
    }
    else
    {
        wifi_host1[0] = 0;
    }

    if(g_wifi_info.f.config.wifi_host2[0])
    {
        if(g_wifi_info.f.config.wifi_host2_port > 0)
        {
            sprintf(wifi_host2, "%s:%i", g_wifi_info.f.config.wifi_host2, g_wifi_info.f.config.wifi_host2_port);
        }
        else
        {
            strcpy(wifi_host2, g_wifi_info.f.config.wifi_host2);
        }
    }
    else
    {
        wifi_host2[0] = 0;
    }
    
    snprintf(out, max_len, 
            "%s"
            "<html>\n"
            "<head>\n"
            "<title>Dom32IO</title>\n"
            "</head>\n"
            "<style>\n"
            "body{background-color:grey;font-size:24pt;}\n"
            "#it{height:75;font-size:24pt}\n"
            "</style>\n"
            "<body>\n"
            "<form method=\"post\">\n"
            "<h1>WiFi</h1>\n"
            "<p>MAC: %s</p>\n"
            "<hr />\n"
            "<h2>AP1:</h2>\n"
            "&nbsp;<input id=\"it\" type=\"text\" name=\"ap1\" value=\"%s\">&nbsp;<input  id=\"it\" type=\"text\" name=\"ap1p\" value=\"%s\"><br>\n"
            "<h2>AP2:</h2>\n"
            "&nbsp;<input id=\"it\" type=\"text\" name=\"ap2\" value=\"%s\">&nbsp;<input  id=\"it\" type=\"text\" name=\"ap2p\" value=\"%s\"><br>\n"
            "<h2>Central:</h2>\n"
            "&nbsp;<input id=\"it\" type=\"text\" name=\"ce1\" value=\"%s\">&nbsp;<input  id=\"it\" type=\"text\" name=\"ce2\" value=\"%s\"><br>\n"
            "<h2>Path:</h2>\n"
            "&nbsp;<input id=\"it\" type=\"text\" name=\"path\" value=\"%s\"><br>\n"
            "<br>\n"
            "<br>\n"
            "&nbsp;&nbsp;<input  id=\"it\" type=\"submit\" value=\"Guardar\">"
            "</form>\n"
            "</body>\n"
            "</html>\n",
            http_200,
            g_wifi_info.status.hw_mac,
            g_wifi_info.f.config.wifi_ap1, g_wifi_info.f.config.wifi_ap1_pass,
            g_wifi_info.f.config.wifi_ap2, g_wifi_info.f.config.wifi_ap2_pass,
            wifi_host1, wifi_host2,
            g_wifi_info.f.config.rqst_path);
}

void HttpReturnWiFiConfig(char *out, int max_len)
{
    snprintf(out, max_len,
            "%sID=%s&TYP=IO&ap1=%s&ap1p=%s&ap2=%s&ap2p=%s&ce1=%s&ce1p=%u&ce2=%s&ce2p=%u&report=%u&rqst=%s",
            http_200,
            g_wifi_info.status.hw_mac,
            g_wifi_info.f.config.wifi_ap1, g_wifi_info.f.config.wifi_ap1_pass,
            g_wifi_info.f.config.wifi_ap2, g_wifi_info.f.config.wifi_ap2_pass,
            g_wifi_info.f.config.wifi_host1, g_wifi_info.f.config.wifi_host1_port,
            g_wifi_info.f.config.wifi_host2, g_wifi_info.f.config.wifi_host2_port,
            g_wifi_info.f.config.report/10, g_wifi_info.f.config.rqst_path);
}


void HttpReturnResult(char *out, const char* result, int max_len)
{
    snprintf(out, max_len,
        "%sID=%s&TYP=IO&RESULT=%s",
        http_200,
        g_wifi_info.status.hw_mac,
        result);
    
    LogMessage("[HttpReturnResult] %s - data-len: %d", result, strlen(out));
}

void HttpProcessWiFiFormConfig(char* in)
{
    char *p;
    
    HTTPGetFormData(in, "ap1", g_wifi_info.f.config.wifi_ap1);
    HTTPGetFormData(in, "ap1p", g_wifi_info.f.config.wifi_ap1_pass);
    HTTPGetFormData(in, "ap2", g_wifi_info.f.config.wifi_ap2);
    HTTPGetFormData(in, "ap2p", g_wifi_info.f.config.wifi_ap2_pass);
    HTTPGetFormData(in, "ce1", g_wifi_info.f.config.wifi_host1);
    HTTPGetFormData(in, "ce2", g_wifi_info.f.config.wifi_host2);
    HTTPGetFormData(in, "path", g_wifi_info.f.config.rqst_path);
    
    /* Separo el port si viene informado */
    p = strchr(g_wifi_info.f.config.wifi_host1, ':');
    if(p)
    {
        g_wifi_info.f.config.wifi_host1_port = atoi(p+1);
        *p = 0;
    }

    p = strchr(g_wifi_info.f.config.wifi_host2, ':');
    if(p)
    {
        g_wifi_info.f.config.wifi_host2_port = atoi(p+1);
        *p = 0;
    }
    
    g_wifi_info.status.save_config = 50;
}

void HttpProcessGeneralConfig(char* in)
{
    char s[32];
    HTTPGetFormData(in, "ap1", g_wifi_info.f.config.wifi_ap1);
    HTTPGetFormData(in, "ap1p", g_wifi_info.f.config.wifi_ap1_pass);
    HTTPGetFormData(in, "ap2", g_wifi_info.f.config.wifi_ap2);
    HTTPGetFormData(in, "ap2p", g_wifi_info.f.config.wifi_ap2_pass);
    HTTPGetFormData(in, "ce1", g_wifi_info.f.config.wifi_host1);
    HTTPGetFormData(in, "ce2", g_wifi_info.f.config.wifi_host2);
    HTTPGetFormData(in, "path", g_wifi_info.f.config.rqst_path);
    if(HTTPGetFormData(in, "ce1p", s))
    {
        g_wifi_info.f.config.wifi_host1_port = atoi(s);
    }
    if(HTTPGetFormData(in, "ce2p", s))
    {
        g_wifi_info.f.config.wifi_host2_port = atoi(s);
    }
    if(HTTPGetFormData(in, "report", s))
    {
        g_wifi_info.f.config.report = atoi(s) * 10;
    }
    if(HTTPGetFormData(in, "reset", s))
    {
        CTRLReset(atoi(s));
    }
    if(HTTPGetFormData(in, "update", s))
    {
        if( !strcmp(s, "firmware"))
        {
            UpdateFirmware();
        }
    }

    g_wifi_info.status.save_config = 50;
}

void HttpProcessCommand(char* in)
{
    char cmd[32];
    
    LogMessage("[HttpProcessCommand] [%.100s]", in);
    if(HTTPGetFormData(in, "Command", cmd))
    {
        LogMessage("[HttpProcessCommand] Comando");
        if( !strcmp(cmd, "download"))
        {
            LogMessage("[HttpProcessCommand] Comando Download");
            if(HTTPGetFormData(in, "Filename", g_download_file_name))
            {
                LogMessage("[HttpProcessCommand] Comando Download Filename: %s", g_download_file_name);
            }
        }
    }
}

void HttpReturnIOStatus(char *out, int max_len)
{
    snprintf(out, max_len,
        "%sID=%s&TYP=IO&IO1=%u&IO2=%u&IO3=%u&IO4=%u&IO5=%u&IO6=%u&OUT1=%u&OUT2=%u&OUT3=%u&OUT4=%u",
        http_200,
        g_wifi_info.status.hw_mac,
        g_control_io.stat1,
        g_control_io.stat2,
        g_control_io.stat3,
        g_control_io.stat4,
        g_control_io.stat5,
        g_control_io.stat6,
        (g_control_out.stat1)?1:0,
        (g_control_out.stat2)?1:0,
        (g_control_out.stat3)?1:0,
        (g_control_out.stat4)?1:0);
    
    /* Version del stack AT del ESP-02 */
    if((MAX_HTTP_DATA - strlen(out) > sizeof(g_wifi_info.status.wifi_at)))
    {
        snprintf(&out[strlen(out)], MAX_HTTP_DATA - strlen(out), 
                "&AT=%s", g_wifi_info.status.wifi_at);
    }
    /* Version del SDK del ESP-02 */
    if((MAX_HTTP_DATA - strlen(out) > sizeof(g_wifi_info.status.wifi_sdk)))
    {
        snprintf(&out[strlen(out)], MAX_HTTP_DATA - strlen(out), 
                "&SDK=%s", g_wifi_info.status.wifi_sdk);
    }
    /* Compilacion del firmware */
    if((MAX_HTTP_DATA - strlen(out) > sizeof(g_wifi_info.status.up_fw)))
    {
        snprintf(&out[strlen(out)], MAX_HTTP_DATA - strlen(out), 
                "&FW=%s", g_wifi_info.status.up_fw);
    }
    /* Capacidad SSL del módulo WIFI */
    if((MAX_HTTP_DATA - strlen(out) > 10))
    {
        snprintf(&out[strlen(out)], MAX_HTTP_DATA - strlen(out), 
                "&SSL=%s", (g_wifi_info.status.wifi_ssl_capable)?"YES":"NO");
    }
    
    LogMessage("HttpReturnIOStatus - data-len: %d", strlen(out));
}

void HttpReturnIOConfig(char *out, int max_len)
{
    snprintf(out, max_len,
            "%sID=%s&TYP=IO&IO1=%s&IO2=%s&IO3=%s&IO4=%s&IO5=%s&IO6=%s",
            http_200,
            g_wifi_info.status.hw_mac,
            (g_wifi_info.f.config.io_config & 0x01)?((g_wifi_info.f.config.an_config & 0x01)?"ana":"in"):"out",
            (g_wifi_info.f.config.io_config & 0x02)?((g_wifi_info.f.config.an_config & 0x02)?"ana":"in"):"out",
            (g_wifi_info.f.config.io_config & 0x04)?((g_wifi_info.f.config.an_config & 0x04)?"ana":"in"):"out",
            (g_wifi_info.f.config.io_config & 0x08)?((g_wifi_info.f.config.an_config & 0x08)?"ana":"in"):"out",
            (g_wifi_info.f.config.io_config & 0x10)?((g_wifi_info.f.config.an_config & 0x10)?"ana":"in"):"out",
            (g_wifi_info.f.config.io_config & 0x20)?((g_wifi_info.f.config.an_config & 0x20)?"ana":"in"):"out");
    if(g_wifi_info.f.config.io_config_default && (strlen(out)+10) < max_len)
    {
        strcat(out, "&GETCONF=1");
    }
}

/* *****************************************************************************
 * Inicializacion, llamar al inicio
 * ************************************************************************** */
void HTTPInit( void )
{
    memset(&http_buffer_input, 0, sizeof(http_data));
    memset(&http_buffer_output, 0, sizeof(http_data));
    memset(&http_buffer_response, 0, sizeof(http_data));
    g_download_file_name[0] = 0;
    http_process_tmp_file = 0;
    g_download_file_count = 0;
    g_download_timer_count = 0;
}

/* *****************************************************************************
 * Tareas de HTTP, llamar desde el loop de procesamiento
 * ************************************************************************** */
void HTTPTask( void )
{
    /* Proceso requerimientos */
    if(http_buffer_input.type == 'G')
    {
        /* GET */
        LogMessage("[HTTPTask] GET: %s %u bytes", http_buffer_input.uri, strlen(http_buffer_input.data));
        if( !strcmp(http_buffer_input.uri, "/"))
        {
            if(g_wifi_info.status.wifi_mode == 3)
            {
                HttpReturnWiFiFormConfig(http_buffer_response.data, MAX_HTTP_DATA);
            }
            else
            {
                strncpy(http_buffer_response.data, http_404, MAX_HTTP_DATA);
            }
        }
        else if( !strcmp(http_buffer_input.uri, "/status.htm"))
        {
            HttpReturnIOStatus(http_buffer_response.data, MAX_HTTP_DATA);
        }
        else if( !strcmp(http_buffer_input.uri, "/iostatus.htm"))
        {
            HttpReturnIOStatus(http_buffer_response.data, MAX_HTTP_DATA);
        }
        else if( !strcmp(http_buffer_input.uri, "/config.htm"))
        {
            HttpReturnIOConfig(http_buffer_response.data, MAX_HTTP_DATA);
        }
        else if( !strcmp(http_buffer_input.uri, "/ioconfig.htm"))
        {
            HttpReturnIOConfig(http_buffer_response.data, MAX_HTTP_DATA);
        }
        else if( !strcmp(http_buffer_input.uri, "/reset.htm"))
        {
            CTRLReset(0);
            HttpReturnResult(http_buffer_response.data, "Ok", MAX_HTTP_DATA);
        }
        else
        {
            strncpy(http_buffer_response.data, http_404, MAX_HTTP_DATA);
        }
        http_buffer_response.type = 'H';
        http_buffer_response.timeout = 100;
        LogMessage("[HTTPTask] Respondiendo: %s %u bytes",
                http_buffer_response.data, strlen(http_buffer_response.data));
    }
    else if(http_buffer_input.type == 'P')
    {
        LogMessage("[HTTPTask] PUT/POST: %s %u bytes",
                http_buffer_input.uri, strlen(http_buffer_input.data));
        if( !strcmp(http_buffer_input.uri, "/"))
        {
            HttpProcessWiFiFormConfig(http_buffer_input.data);
            HttpReturnWiFiFormConfig(http_buffer_response.data, MAX_HTTP_DATA);
        }
        else if( !strcmp(http_buffer_input.uri, "/command.cgi"))
        {
            HttpProcessCommand(http_buffer_input.data);
            HttpReturnResult(http_buffer_response.data, "Ok", MAX_HTTP_DATA);
        }
        else if( !strcmp(http_buffer_input.uri, "/wifi.cgi"))
        {
            HttpProcessWiFiFormConfig(http_buffer_input.data);
            HttpReturnWiFiConfig(http_buffer_response.data, MAX_HTTP_DATA);
        }
        else if( !strcmp(http_buffer_input.uri, "/config.cgi"))
        {
            HttpProcessGeneralConfig(http_buffer_input.data);
            HttpReturnResult(http_buffer_response.data, "Ok", MAX_HTTP_DATA);
        }
        else if( !strcmp(http_buffer_input.uri, "/iostatus.cgi"))
        {
            CTRLSetIO(http_buffer_input.data);
            HttpReturnIOStatus(http_buffer_response.data, MAX_HTTP_DATA);
        }
        else if( !strcmp(http_buffer_input.uri, "/ioswitch.cgi"))
        {
            CTRLSwitchIO(http_buffer_input.data);
            HttpReturnIOStatus(http_buffer_response.data, MAX_HTTP_DATA);
        }
        else if( !strcmp(http_buffer_input.uri, "/ioconfig.cgi"))
        {
            CTRLConfIO(http_buffer_input.data);
            HttpReturnIOConfig(http_buffer_response.data, MAX_HTTP_DATA);
        }
        else
        {
            strncpy(http_buffer_response.data, http_404, MAX_HTTP_DATA);
        }
        /* Completo la respuesta */
        http_buffer_response.type = 'H';
        http_buffer_response.timeout = 100;
        LogMessage("[HTTPTask] Respondiendo: %s %u bytes",
                http_buffer_response.data, strlen(http_buffer_response.data));
    }
    /* Proceso respuestas */
    else if(http_buffer_input.type == 'H')
    {
        /* Se trata de una respuesta HTTP/1... */
        if(http_buffer_input.http_rc == 200 &&
           http_buffer_input.form_rc == 0 )
        {
            /* Ok */
            g_wifi_info.status.host_conectado = 1;
            CTRLNotificarStatus(0);
            CTRLSetIO(http_buffer_input.data);
            CTRLConfSys(http_buffer_input.data);
            
            /* En el proximo arranque inicia en modo normal */
            if(g_wifi_info.f.config.start_config_mode)
            {
                g_wifi_info.f.config.start_config_mode = false;
                ConfigSave();
            }
        }
        else
        {
            /* Error */
            g_wifi_info.status.host_conectado = 0;
            WifiSwitchHost();
        }
        g_wifi_info.status.count_inactividad = 0;
    }
    else if(http_buffer_input.type)
    {
        LogMessage("[HTTPTask] typ: %c DESCONOCIDO %-.100s",
                http_buffer_input.type,
                http_buffer_input.data);
    }
    http_buffer_input.type = 0;
    http_buffer_input.timeout = 0;
}

/* *****************************************************************************
 * Se lo llama 10 veces por segundo
 * ************************************************************************** */
void HTTPTimer( void )
{
    if(http_buffer_input.type && http_buffer_input.timeout)
    {
        http_buffer_input.timeout--;
        if(http_buffer_input.timeout == 0)
        {
            http_buffer_input.type = 0;
            http_buffer_input.download = 0;
            LogMessage("[HTTPTimer] TIMEOUT de mensaje entrante");
        }
    }

    if(http_buffer_output.type && http_buffer_output.timeout)
    {
        http_buffer_output.timeout--;
        if(http_buffer_output.timeout == 0)
        {
            LogMessage("[HTTPTimer] TIMEOUT de mensaje saliente");
            http_buffer_output.type = 0;
            http_buffer_output.download = false;
        }
    }

    if(http_buffer_response.type && http_buffer_response.timeout)
    {
        http_buffer_response.timeout--;
        if(http_buffer_response.timeout == 0)
        {
            http_buffer_response.type = 0;
            LogMessage("[HTTPTimer] De respuesta saliente");
        }
    }
    
    if(http_process_tmp_file)
    {
        http_process_tmp_file--;
        if(http_process_tmp_file == 0)
        {
            if(HTTPProcessTmpFile(DOWNLOAD_TEMP_FILE_NAME, 
                    http_process_tmp_file_to_name, 
                    http_buffer_input.download_length) == 0)
            {
                /* Finalizado Ok */
                g_download_timer_count = 0;
                if( !strcmp(http_process_tmp_file_to_name, FIRMWARE_FILENAME))
                {
                    CTRLReset(0);
                }
                http_process_tmp_file_to_name[0] = 0;
            }
            else
            {
                /* Download Error */
                FSremove(http_process_tmp_file_to_name);
            }
            /* Borro el archivo temporal */
            FSremove(DOWNLOAD_TEMP_FILE_NAME);
        }
    }
    
    if(http_buffer_output.type == 0 &&
       http_buffer_input.type == 0 &&
       http_buffer_response.type == 0 &&
       g_download_file_name[0] )
    {
        if(g_download_file_count == 0)
        {
            g_download_file_count = 50;
        }
        else
        {
            g_download_file_count--;
            if(g_download_file_count == 0)
            {
                if(HTTPGetFile(g_download_file_name, (g_download_file_params[0])?g_download_file_params:NULL) > 0)
                {
                    g_download_file_name[0] = 0;
                    g_download_file_params[0] = 0;
                }
            }
        }
    }

    if(g_download_timer_count > 0)
    {
        g_download_timer_count--;
        if(g_download_timer_count == 0)
        {
            /* time-out de download */
            http_buffer_output.download = 0;
            http_buffer_input.download = 0;


            FSremove(DOWNLOAD_TEMP_FILE_NAME);
            /* Reintento el download */
            
            
            
        }
    }

}

/* *****************************************************************************
 * Agrega un mensaje HTTP entrante para su tratamiento segun su tipo
 * P - POST recibido, hay que procesar
 * G - GET recibido, hay que procesar
 * H - Una respuesta
 * ************************************************************************** */
int HTTPAddInput(int id, const char* buffer)
{
    char *p;

    if(http_buffer_input.type)
    {
        LogMessage("[HTTPAddInput] Buffer de entrada ocupado");
        return (-1);
    }
    
    LogMessage("[HTTPAddInput] %-.100s...", buffer);
    
    if(*buffer == 'G' || *buffer == 'P')
    {
        /* Requerimiento */
        http_buffer_input.type = *buffer;
        http_buffer_input.id = id;
        http_buffer_input.timeout = 50;

        if(HttpGetRequest(buffer, http_buffer_input.uri, MAX_HTTP_URI) <= 0)
        {
            LogMessage("[HTTPAddInput] URI Overflow");
            return (-1);
        }
        if(http_buffer_input.type == 'P')
        {
            /* PUT / POST */
            p = strstr(buffer, "\r\n\r\n");
            if(p)
            {
                p += 4;
                if(HttpDecodeFormData(http_buffer_input.data, p, MAX_HTTP_DATA) <= 0)
                {
                    LogMessage("[HTTPAddInput] FORM Overflow");
                    return (-1);
                }
            }
        }
        return 1;
    }
    else if(*buffer == 'H')
    {
        /* Respuesta */
        LogMessage("[HTTPAddInput] Respuesta");
        
        http_buffer_output.type = 0;
        
        http_buffer_input.type = *buffer;
        http_buffer_input.http_rc = HTTPHeadResponse(buffer);
        http_buffer_input.timeout = 50;
        if(http_buffer_input.http_rc == 200)
        {
            p = strstr(buffer, "\r\n\r\n");
            if(p)
            {
                p += 4;
                if(HttpDecodeFormData(http_buffer_input.data, p, MAX_HTTP_DATA) <= 0)
                {
                    LogMessage("[HTTPAddInput] FORM Overflow");
                    return (-1);
                }
                http_buffer_input.form_rc = HTTPFormResponse(http_buffer_input.data);
                if(http_buffer_input.form_rc != 0)
                {
                    LogMessage("[HTTPAddInput] FORM Error %i", http_buffer_input.form_rc);
                }
            }
            return 1;
        }
        else
        {
            LogMessage("[HTTPAddInput] HTTP Error %i", http_buffer_input.http_rc);
            http_buffer_input.form_rc = 0;
            http_buffer_input.download = 0;
        }
    }
    return 0;
}
    
int HTTPAddOutput(const char* filename, bool download, const char* buffer, unsigned int to_cs)
{
    int i;
    
    if(http_buffer_output.type)
    {
        LogMessage("[HTTPAddOutput] Buffer de salida ocupado");
        return (-1);
    }
    
    LogMessage("[HTTPAddOutput] %-.100s...", buffer);
    
    http_buffer_output.timeout = to_cs;
    http_buffer_output.type = *buffer;
    http_buffer_output.id = 0;
    http_buffer_output.download = (download)?1:0;
    /* Saco HttpDecodeFormData cuando genero un mensaje saliente porque
     * necesito que estén las secuencias de escape
    if(HttpDecodeFormData(http_buffer_output.data, buffer, MAX_HTTP_DATA) <= 0)
    {
        LogMessage("[HTTPAddInput] FORM Overflow");
        return (-1);
    }
    */
    strncpy(http_buffer_output.data, buffer, MAX_HTTP_DATA);
    /* Avanzo hasta la ultima '/' para dejar el nombre sin path */
    while(strchr(filename, '/'))
    {
        while(*filename != '/') filename++;
        filename++;
    }
    
    /* copio solo caracteres validos */
    for(i = 0; *filename; filename++)
    {
        if( (*filename >= '0' && *filename <= '9') ||
            (*filename >= 'a' && *filename <= 'z') ||
            (*filename >= 'A' && *filename <= 'Z') ||
             *filename == '.' || *filename == '_' )
        {
            http_buffer_output.filename[i++] = *filename;
        }
    }
    http_buffer_output.filename[i] = 0;

    return 1;
}

int HTTPAddResponse(int id, const char* buffer)
{
    if(http_buffer_response.type)
    {
        LogMessage("[HTTPAddResponse] Buffer de salida ocupado");
        return (-1);
    }
    
    LogMessage("[HTTPAddResponse] %-.100s...", buffer);
    
    http_buffer_response.timeout = 100;
    http_buffer_response.type = 'H';
    http_buffer_response.id = id;
    if(HttpDecodeFormData(http_buffer_response.data, buffer, MAX_HTTP_DATA) <= 0)
    {
        LogMessage("[HTTPAddResponse] FORM Overflow");
        return (-1);
    }
    return 1;
}

/* *****************************************************************************
 * Genera un mensaje WEB con formato de formulario POST
 * y lo copia a un buffer (respuesta) o encola para enviar (notificación)
 * ************************************************************************** */
int HTTPNotificarStatus()
{
    bool first_change = false;
    char tmp_uri[MAX_HTTP_URI+1];
    char tmp_data[MAX_HTTP_DATA+1];
    char tmp_rqst[MAX_HTTP_DATA+1];
    
    /* Parte fija con la MAC y las entradas y salidas */
    snprintf(tmp_data, MAX_HTTP_DATA,
        "ID=%s&TYP=IO&IO1=%u&IO2=%u&IO3=%u&IO4=%u&IO5=%u&IO6=%u&OUT1=%u&OUT2=%u&OUT3=%u&OUT4=%u",
        g_wifi_info.status.hw_mac,
        g_control_io.stat1,
        g_control_io.stat2,
        g_control_io.stat3,
        g_control_io.stat4,
        g_control_io.stat5,
        g_control_io.stat6,
        (g_control_out.stat1)?1:0,
        (g_control_out.stat2)?1:0,
        (g_control_out.stat3)?1:0,
        (g_control_out.stat4)?1:0);
    
    if( g_control_io.change1 ||
        g_control_io.change2 ||
        g_control_io.change3 ||
        g_control_io.change4 ||
        g_control_io.change5 ||
        g_control_io.change6 ||
        g_control_out.change1 ||
        g_control_out.change2 ||
        g_control_out.change3 ||
        g_control_out.change4  )
    {
        strcat(tmp_data, "&CHG=");
        first_change = true;
        
        if(g_control_io.change1)
        {
            if(!first_change) strcat(tmp_data, ",");
            first_change = false;
            strcat(tmp_data, "IO1");
        }
        if(g_control_io.change2)
        {
            if(!first_change) strcat(tmp_data, ",");
            first_change = false;
            strcat(tmp_data, "IO2");
        }
        if(g_control_io.change3)
        {
            if(!first_change) strcat(tmp_data, ",");
            first_change = false;
            strcat(tmp_data, "IO3");
        }
        if(g_control_io.change4)
        {
            if(!first_change) strcat(tmp_data, ",");
            first_change = false;
            strcat(tmp_data, "IO4");
        }
        if(g_control_io.change5)
        {
            if(!first_change) strcat(tmp_data, ",");
            first_change = false;
            strcat(tmp_data, "IO5");
        }
        if(g_control_io.change6)
        {
            if(!first_change) strcat(tmp_data, ",");
            first_change = false;
            strcat(tmp_data, "IO6");
        }
        if(g_control_out.change1)
        {
            if(!first_change) strcat(tmp_data, ",");
            first_change = false;
            strcat(tmp_data, "OUT1");
        }
        if(g_control_out.change2)
        {
            if(!first_change) strcat(tmp_data, ",");
            first_change = false;
            strcat(tmp_data, "OUT2");
        }
        if(g_control_out.change3)
        {
            if(!first_change) strcat(tmp_data, ",");
            first_change = false;
            strcat(tmp_data, "OUT3");
        }
        if(g_control_out.change4)
        {
            if(!first_change) strcat(tmp_data, ",");
            first_change = false;
            strcat(tmp_data, "OUT4");
        }
    }
    
    /* Agrego una marca para que la base sepa si estuve offline */
    if(g_wifi_info.status.host_conectado)
    {
        strcat(tmp_data, "&ONLINE=1");
    }
    else
    {
        strcat(tmp_data, "&ONLINE=0");
    }
    
    /* Version del stack AT del ESP-02 */
    if((MAX_HTTP_DATA - strlen(tmp_data) > strlen(g_wifi_info.status.wifi_at)))
    {
        snprintf(&tmp_data[strlen(tmp_data)], MAX_HTTP_DATA - strlen(tmp_data), 
                "&AT=%s", g_wifi_info.status.wifi_at);
    }
    /* Version del SDK del ESP-02 */
    if((MAX_HTTP_DATA - strlen(tmp_data) > strlen(g_wifi_info.status.wifi_sdk)))
    {
        snprintf(&tmp_data[strlen(tmp_data)], MAX_HTTP_DATA - strlen(tmp_data), 
                "&SDK=%s", g_wifi_info.status.wifi_sdk);
    }
    /* Compilacion del firmware */
    if((MAX_HTTP_DATA - strlen(tmp_data) > strlen(g_wifi_info.status.up_fw)))
    {
        snprintf(&tmp_data[strlen(tmp_data)], MAX_HTTP_DATA - strlen(tmp_data), 
                "&FW=%s", g_wifi_info.status.up_fw);
    }

    /* Agrego solicitud de configuración */
    if(g_wifi_info.f.config.io_config_default && (MAX_HTTP_DATA - strlen(tmp_data) > 10) )
    {
        strcat(tmp_data, "&GETCONF=1");
    }
    
    snprintf(tmp_uri, MAX_HTTP_URI, "%s/infoio.cgi", g_wifi_info.f.config.rqst_path);
    /* POST
     * 1.- %s: URI
     * 2.- %s: Host
     * 3.- %d: Content-Length
     * 4.- %s: datos
     */
    snprintf(tmp_rqst, MAX_HTTP_DATA, http_post,
            tmp_uri,
            g_wifi_host,
            strlen(tmp_data),
            tmp_data);

    LogMessage("[HTTPNotificarStatus] - data-len: %d", strlen(tmp_rqst));

    if(HTTPAddOutput(tmp_uri, false, tmp_rqst, 250) <= 0)
    {
        /* No fue posible enviar */
        return 0;
    }
    
    /* Reseteo los cambios */
    g_control_io.change1 = 0;
    g_control_io.change2 = 0;
    g_control_io.change3 = 0;
    g_control_io.change4 = 0;
    g_control_io.change5 = 0;
    g_control_io.change6 = 0;
    g_control_out.change1 = 0;
    g_control_out.change2 = 0;
    g_control_out.change3 = 0;
    g_control_out.change4 = 0;

    return strlen(tmp_rqst);
}

int HTTPNotificarTarjeta( const char *crd)
{
    char tmp_uri[MAX_HTTP_URI+1];
    char tmp_data[MAX_HTTP_DATA+1];
    char tmp_rqst[MAX_HTTP_DATA+1];

    LogMessage("[HTTPNotificarTarjeta] %s", crd);

    snprintf(tmp_data, MAX_HTTP_DATA, "ID=%s&TYP=IO&CARD=%s", g_wifi_info.status.hw_mac, crd);
    snprintf(tmp_uri, MAX_HTTP_URI, "%s/infoio.cgi", g_wifi_info.f.config.rqst_path);

    /* POST
     * 1.- %s: URI
     * 2.- %s: Host
     * 3.- %d: Content-Length
     * 4.- %s: datos
     */
    snprintf(tmp_rqst, MAX_HTTP_DATA, http_post,
            tmp_uri,
            g_wifi_host,
            strlen(tmp_data),
            tmp_data);
    if(HTTPAddOutput(tmp_uri, false, tmp_rqst, 250) <= 0)
    {
        /* No fue posible enviar */
        return 0;
    }
    return strlen(tmp_rqst);
}
