wpirri/dom32-io-wifi/Programa_BORRAR/config.c

/***************************************************************************
    Copyright (C) 2020   Walter Pirri

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
    You should have received a copy of the GNU Lesser General Public
    License along with this library; if not, write to the Free Software
    Foundation, Inc., 59 Temple Place, Suite 330, Boston, MA  02111-1307  USA
 ***************************************************************************/
#define _IN_CONFIG_C_
#include "config.h"
#undef _IN_CONFIG_C_

#include <string.h>
#include <stdlib.h>
#include <stdio.h>
#include <stdint.h>

#include "main.h"
#include "control.h"

#define CONFIG_FLASK_OK 0xA5A55A5A

/* Have compiler allocate a page of flash from the NVM.  Aligned to a page. */
static const uint32_t __attribute((space(prog),aligned(FLASH_ERASE_PAGE_SIZE_IN_PC_UNITS))) flash_reserved_space[FLASH_ERASE_PAGE_SIZE_IN_PC_UNITS/4];

void ConfigLoadDefault( void)
{
    memset(&g_wifi_info.f.config, 0, sizeof(g_wifi_info.f.config));
    g_wifi_info.f.config.io_config = 0xFF;
    g_wifi_info.f.config.exp_io_config = 0xFF;
    g_wifi_info.f.config.wifi_host1_port = 80;
    g_wifi_info.f.config.wifi_host2_port = 80;
    strcpy(g_wifi_info.f.config.rqst_path, "/cgi-bin");
    g_wifi_info.f.config.io_config_default = 1;

    g_wifi_info.f.config.flash_ok = CONFIG_FLASK_OK;

    g_wifi_info.status.save_config = 10;
}

void ConfigInit( void )
{
    memset(&g_wifi_info, 0, sizeof(wifi_info));
}

void ConfigLoad( void )
{
    int i;
    uint32_t f = (uint32_t)flash_reserved_space;
    
    for(i = 0; i < FLASH_ARRAY; i++)
    {
        g_wifi_info.f.ui32[i] = FLASH_ReadWord( f + (i*4) );
    }
    
    if(g_wifi_info.f.config.flash_ok != CONFIG_FLASK_OK)
    {
        ConfigLoadDefault();
    }
}

void ConfigSave(void)
{
    int i;
    uint32_t f = (uint32_t)flash_reserved_space;

    g_wifi_info.status.flash_error = false;
    g_wifi_info.status.save_config = 0;
    
    g_wifi_info.f.config.an_config = (
            ((g_control_io.ana1)?0x01:0) |
            ((g_control_io.ana2)?0x02:0) |
            ((g_control_io.ana3)?0x04:0) |
            ((g_control_io.ana4)?0x08:0) );

    g_wifi_info.f.config.io_config = (
            ((g_control_io.dir1)?0x01:0) |
            ((g_control_io.dir2)?0x02:0) |
            ((g_control_io.dir3)?0x04:0) |
            ((g_control_io.dir4)?0x08:0) );

    g_wifi_info.f.config.exp_an_config = (
            ((g_control_exp.ana1)?0x01:0) |
            ((g_control_exp.ana3)?0x02:0) |
            ((g_control_exp.ana4)?0x04:0) |
            ((g_control_exp.ana5)?0x08:0) |
            ((g_control_exp.ana7)?0x10:0) |
            ((g_control_exp.ana8)?0x20:0) |
            ((g_control_exp.ana9)?0x40:0) );

    g_wifi_info.f.config.exp_io_config = (
            ((g_control_exp.dir1)?0x01:0) |
            ((g_control_exp.dir3)?0x02:0) |
            ((g_control_exp.dir4)?0x04:0) |
            ((g_control_exp.dir5)?0x08:0) |
            ((g_control_exp.dir7)?0x10:0) |
            ((g_control_exp.dir8)?0x20:0) |
            ((g_control_exp.dir9)?0x40:0) );

    FLASH_Unlock(FLASH_UNLOCK_KEY);

    FLASH_ErasePage(f);
    
    for(i = 0; i < FLASH_ARRAY; i+=2)
    {
        if(FLASH_WriteDoubleWord( f + (i*4), 
                                  g_wifi_info.f.ui32[i],
                                  g_wifi_info.f.ui32[i+1]) == 0)
        {
            g_wifi_info.status.flash_error = true;
        }
    }
    
    FLASH_Lock();
}

void ConfigTimer(void)
{
    if(g_wifi_info.status.save_config)
    {
        g_wifi_info.status.save_config--;
        if(g_wifi_info.status.save_config == 0)
        {
            ConfigSave();
            CTRLInit();
        }
    }
    
}
