wpirri/dom32-io-wifi/Programa/delay.h

/* 
 * File:   delay.h
 * Author: walter
 *
 * Created on 13 de agosto de 2018, 20:48
 */

#ifndef DELAY_H
#define	DELAY_H
//#include <GenericTypeDefs.h>

void __delay_ms(unsigned long ms);
void __delay_us(unsigned long us);

#endif	/* DELAY_H */
