wpirri/dom32-io-wifi/(commit log)

2020-10-19 Reacondicionamiento base.
    Por el tamaño del procesador se decide no utilizar colas que requieren alocación dinamica de memoria. Se elimina el código asociado y se vuelven a generar los modulos con Code Congurator.
2020-10-21 Avance
    Avance: Desarrollo de interface con modulo wifi
2020-10-22 Correccion
    Se agrega la conexion del pin 6 del modulo wifi
2020-10-22 AT
    Comando AT enviado OK
    Se agregó el Clear al WDT
2020-10-22 AT -> OK
    Se agrega limpieza del buffer de entrada serial y reconocimiento de las respuesta OK
2020-11-05 WiFi Init
    Secuencia de inicializacion WiFi funcionando. Arranca en modo AP esperando aceptando conexion sin passsord por 60 segundos. El led de status indica conexi[on y a que AP el led de modo indica si est;a como STA o como AP
2020-11-06 Respuesta HTTP
    Implementado el reconocimiento, tratamiento y respuesta de mensaje HTTP.
    Falta todo un tramo de tratamiento de formularios
2020-11-07 Formulario
    Implementada la configuracion Wifi desde formulario
2020-11-07 Leds diferidos
    Se difiere el momento en que titilan los leds para facilitar la interpretación
2020-11-09 Flash Ok
    Configuración en flash Ok
    Se agrega No Solicitado de captura de version de firmware, Sin terminar.
2020-11-09 Correcciones flash
    Correcciones a la implementaci[on de la configuracipn den flash
2020-11-11 Control
    ensajeria y manejo de modo y estado de la interface
2020-11-16 Notificacion
    Mensaje de notificacion a central por medio de un POST
2020-11-16 Finde linea
    Cambios en la deteccion de fin de linea para diferenciar comandos de stream
2020-11-16 HW ID
    Se agrega la captura de la MAC de la interface Wifi Station y se informa en el reporte de eventos como ID del dispositivo.
2020-11-18 Mejoras web
    Mejoras en la comunicacion web, espera en el close y mejorada la deteccion de fin de lineas y/o stream.
    Cambios en la secuencia de inicio, los leds se alternan hasta que arranca el modulo wifi.
2020-11-22 IO Expansion
    Configuracion y controlde puerto de expansion
    Contrl de pull-up en entradas
2020-11-28 Notificacion
    Cambios en el contador para notificar.
    Cambios en el momento de los cambios de estado.
    Se cambia el puerto de escucha de 3100 a 80.
2020-12-08 Pre SSL
    Preparacion para SSL
2020-12-10 Formularios de configuracion y control
    Se agregan formularios para configuración de puertos y gestion de estados
2020-12-11 Correccion de configuracion
    Correccion en el pasaje de datos de configuracion
2020-12-19 Reintento de notificacion
    Se agrega una modificacion para que reinente el envío de notificación si no se encontró un slot libre para cargar el mensaje en la cola circular.
2020-12-19 Correccion en notificacion
    Se corrije el modo de setear las notificaciones por cambios de estado
2021-02-06 Procesamiento de respuesta HTTP
    Se agregó el procesamiento de las respuestas HTTP para obtener información de configuración o comandos de cambios de estado.
2021-03-13 dht11 y Wiegand
    Se agregan las funcionalidades de interface con sensor de temperatura y humedad dht11 y lector de tarjetas wiegand
2021-03-13 Nueva doc
    Se agrega documentación de diseño
2021-05-01 Update http.c
    Interface http ampliada. Se agregan consultas de estados, configuración de puertos y configuracion de wifi con mensajeria de servicios web sin formularios.
2021-07-26 Comando Switch
    Se agrega el comando switch que cambia el estado de los puertos seleccionados
2021-07-26 Delay de input
    Se agrega un delay para los estados de las entradas como filtro de ruido
2021-11-30 Se corrige capacitor electrolitico para nuevas librerias
    Se corrige capacitor electrolitico para nuevas librerias
2022-02-15 Cambio de planes
    Cambio de planes
2022-02-21 Nuevo circuito co relees
    Nuevo circuito co relees
2022-03-07 Formulario de configuracion
    Formulario de configuracion
2022-03-11 Correccion del core timer
    Correccion del core timer
2022-03-12 Revert "Correccion del core timer"
    This reverts commit e15d4be750ec0100916b0a144cfc09ea950c0574.
2022-03-12 Aumento de la frecuencia del micro usando PLL
    Aumento de la frecuencia del micro usando PLL
2022-03-16 Ultimo update antes de volver a fuentes anteriores
    Ultimo update antes de volver a fuentes anteriores
2022-03-17 Correcciones al circuito y avance con la placa
    Correcciones al circuito y avance con la placa
2022-03-17 Debug de mensajeria http
    Debug de mensajeria http
2022-03-18 Update
    Configuracion de 6 IO y 4 OUT
2022-03-19 Correcion mensaje de notificacion
    Correcion mensaje de notificacion
2022-03-19 PCB
    PCB
2022-03-21 Antes de agregar areas de relleno
    Antes de agregar areas de relleno
2022-03-22 Final PCB
    Final PCB
2022-03-23 Versión revisada para solicitud de cotización
    Versión revisada para solicitud de cotización
2022-04-03 Se agrega el gabinete
    Se agrega el gabinete
2022-04-06 Medidas corregidas de las perforaciones
    Medidas corregidas de las perforaciones
2022-04-24 Correcciones de puesta en marcha de placa nueva
    Correcciones de puesta en marcha de placa nueva
2022-04-24 Logo en el gabinete
    Logo en el gabinete
2022-04-24 Correccion en mascara de cambios informados
    Correccion en mascara de cambios informados
2022-04-25 Se saca control de led aux por trafico
    Se saca control de led aux por trafico
2022-04-25 Se agrega funcionalidad de pulso
    Se agrega funcionalidad de pulso
2022-05-07 Desactivacion rapida de logueo y se deja de borrar cualquier mensaje entrante del serial RX del modem cuando se escribe algo para el TX
    Desactivacion rapida de logueo y se deja de borrar cualquier mensaje entrante del serial RX del modem cuando se escribe algo para el TX
2022-05-16 Se agrega info en el arranque, fecha de compilación, firmware wifi, etc
    Se agrega info en el arranque, fecha de compilación, firmware wifi, etc
2022-05-18 Conversion de caracteres de escape en formularios
    Conversion de caracteres de escape en formularios
2022-05-18 Titila el led AUX cuando está en linea con la central
    Titila el led AUX cuando está en linea con la central
2022-05-18 Se descomenta la notificacion por cambio en una salida
    Se descomenta la notificacion por cambio en una salida
2022-05-19 Retraso en el control de cambios para evitar transmitir cambios cuando arranca y cuando actualiza configuración
    Retraso en el control de cambios para evitar transmitir cambios cuando arranca y cuando actualiza configuración
2022-05-20 Se acorta el ojo de buey
    Se acorta el ojo de buey
2022-05-23 Definición de flags para https, wiegand y dht11
    Definición de flags para https, wiegand y dht11
2022-05-25 Create Dom32 IO WiFi - Manual de Usuario.doc
2022-05-29 Incorporacion de DHT11/21
    Incorporacion de DHT11/21. Todavía no funciona.
2022-05-30 Circuito completo de temperatura y humedad
    Circuito completo de temperatura y humedad
2022-06-07 Archivos de la placa vieja
    Archivos de la placa vieja
2022-06-07 Se agregan las orejas de fijacion para tornillos
    Se agregan las orejas de fijacion para tornillos
2022-06-07 Serial RX a ningún pin
    Serial RX a ningún pin
2022-06-11 Se unifica la función que genera el mensaje de estados y se cambia el formato para informar los cambios
    Se unifica la función que genera el mensaje de estados y se cambia el formato para informar los cambios
2022-06-16 Solo permitir configuracion analogica en las entradas que lo soportan
    Solo permitir configuracion analogica en las entradas que lo soportan
2022-06-28 Cambio en el formato de transmitir estados
    Cambio en el formato de transmitir estados
2022-08-15 Uso de central de backup
    Uso de central de backup
2022-09-01 Reconexion en caso de errores cosecutivos
    Reconexion en caso de errores cosecutivos
2022-09-06 Correcciones a reinicio de conexion
    Correcciones a reinicio de conexion
2022-09-10 Update Dom32 IO WiFi - Manual de Usuario.doc
2022-10-07 Logueo, RTCC y optimización de comm
    Se agrega LogMessage como funcion que agrega la hora al log por consola. Se agrega el RTCC. Falta sincronizar hora.
2022-10-09 Parseo de fecha y hora en mensaje de configuración
    Parseo de fecha y hora en mensaje de configuración
2022-11-08 Actualizacion de la documentacion
    Actualizacion de la documentacion
2022-11-08 Mejora en tiempo de respuesta
    Mejora en tiempo de respuesta
2022-11-27 Correccion en respuesta a servicio de cambio de estado
    Correccion en respuesta a servicio de cambio de estado
2022-12-01 Correccion de respuesta a solicitudes de cambio de estado de IO y OUT
    Correccion de respuesta a solicitudes de cambio de estado de IO y OUT
2022-12-03 Correcciones de pulso
    Correcciones de pulso
2022-12-08 Cambio en delay para SHT para que funcione con codigo optimizado
    Cambio en delay para SHT para que funcione con codigo optimizado
2022-12-14 Controles de buffer overflow
    Controles de buffer overflow
2022-12-23 Se agrega script para crear codigos QR
    Se agrega script para crear codigos QR
2022-12-23 Correccion de lectura de tarjeta
    Correccion de lectura de tarjeta
2022-12-27 Correcciones para entradas analogicas
    Correcciones para entradas analogicas
2022-12-28 Soporte para modulos WiFi viejos y SSL
    Soporte para modulos WiFi viejos y SSL
2022-12-29 Revert "Soporte para modulos WiFi viejos y SSL"
    This reverts commit 03d2193ffad1442d9ba60e12a8d075d06c20ac8a.
2022-12-30 Correcciones en maquinas de estados
    Correcciones en maquinas de estados
2023-01-09 Ventilacion para sensor de temperatura y humedad
    Ventilacion para sensor de temperatura y humedad
2023-01-16 Componentes actualizados
    Regulador 3v3 que soporta Vin de 18V
    ESP-02 Version nueva
2023-01-23 Datos de Firmware en mensajes de estado y cambios de estado
    Datos de Firmware en mensajes de estado y cambios de estado
2023-01-24 Se alarga el pulsador
    Se alarga el pulsador
2023-01-27 Control de soporte SSL
    Control de soporte SSL
2023-02-07 Autodetect de sensor DHT
    Autodetect de sensor DHT
2023-02-07 Cambio en resistencia 22R por 33R
    Cambio en resistencia 22R por 33R
2023-02-08 Se elimina la optimización en estas dos funciones que provocan error en la comunicación con el ESP-02
    Se elimina la optimización en estas dos funciones que provocan error en la comunicación con el ESP-02
2023-02-10 Se limita el acceso a la página de configuración solo mientras está encendido el AP
    Se limita el acceso a la página de configuración solo mientras está encendido el AP
2023-02-10 Se altera la secuencia de leds durante el encendido para poder verificar los tres leds
    Se altera la secuencia de leds durante el encendido para poder verificar los tres leds
2023-02-10 Se eliminan funciones no usadas de las funciones autogeneradas.
    Se eliminan funciones no usadas de las funciones autogeneradas.
2023-02-10 Se agrega un delay en la escritura del buffer serial
    Se agrega un delay en la escritura del buffer serial
2023-02-14 Se elimina la desabilitación de interrupciones en funciones de DHT
    Se elimina la desabilitación de interrupciones en funciones de DHT
2023-02-14 Revert "Autodetect de sensor DHT"
    This reverts commit 9b306b6f970464da3af8964a75de3c61d7096483.
2023-02-14 Se vuelve atras la deteccion automatica de DHT
2023-02-14 Correcciones para que no se cuelgue con el DHT funcionando
    Correcciones para que no se cuelgue con el DHT funcionando
2024-02-09 Mensaje con modelo en el log
    Mensaje con modelo en el log
2024-02-13 Se agregan datos en el mensaje e estado
    Se agrega en el mensaje de estado TYP=IO para diferenciarlo de IR y de PI.
    Se agrega en el mensaje de estado SSL y YES / NO dependiendo del soporte para SSL en el modulo Wifi
2024-03-08 Mejoras on-line
    Se agrega analisis de la respuesta para detectar errores de HTML y del sistema
2024-03-20 Comparacion de estado en la respuesta
    Comparacion de estado en la respuesta
2024-03-28 Colas de mensajes contra modulo wifi mejoradas
    Colas de mensajes contra modulo wifi mejoradas
2024-03-28 Cambio de estado en respuesta
    Cambio de estado en respuesta
2024-04-01 Mejora en sincronización de hora
    Mejora en sincronización de hora
2024-04-08 Mapeo de pines para SPI2
    Mapeo de pines para SPI2
2024-05-03 No se borra el programa de la SD
    No se borra el programa de la SD
2024-05-03 Agregado de MicroSD
    Agregado de MicroSD
2024-05-08 Implementado Download de Formware y RESET para su carga
    Implementado Download de Formware y RESET para su carga
2024-05-08 Leds mas lentos
    Leds mas lentos
2024-05-11 Backup de config en flash
    Backup de config en flash
2024-05-13 Mejoras flash / SD
    Se inhibe la lectura y escritura de configuracion y el download cuando no se detecta la tarjeta SD
2024-06-29 Nueva implementación de upload de firmware
    Nueva implementación de upload de firmware
2024-07-30 Correcciones de update de firmware y configuracion
    Correcciones de update de firmware y configuracion
2024-11-25 Mejoras WiFi
    Se acorta el tiempo de inicio del modulo wifi
    Se cambia la forma de inicio para que saltee el modo cnofigracion
    Se mejora la transferencia de archivo
2024-11-26 Mejoras en la inicializacion WiFi
    Mejoras en la inicializacion WiFi
2024-11-26 Comando de download corregido
    Comando de download corregido
2024-12-02 Compatibilidad de configuración
    Soporte para cambios en tamaño de archivo de configuración sin perder los datos
2024-12-06 Equiparacion de fuentes
    Equiparacion de fuentes
2025-01-09 Correccion en manejo de comunicacion
    Correccion en manejo de comunicacion
2025-01-10 Correccion estructura de configuracion
    Correccion estructura de configuracion
2025-04-19 Conreol de IP de WiFi
    Conreol de IP de WiFi
2025-06-06 Control para evitar errores en pulso
    Control para evitar errores en pulso
2025-09-28 Comando para reset y Update de firmware
    Comando para reset y Update de firmware
2025-09-29 Code Refresh
    Actualización después de una vuelta atrás y reimpacto de modificaciones con correccion de algunos errores en el uso de los flags de conexión
2025-10-03 Vuelta a tras de algunos cambios que rompian el download
    Vuelta a tras de algunos cambios que rompian el download
2025-10-04 Se actualiza con cambios en firmware de touch
    Se actualiza con cambios en firmware de touch
2025-10-04 Download de cualquier tipo de archivo
    Download de cualquier tipo de archivo
2025-10-09 Control de integridad de archivo bajado
    Control de integridad de archivo bajado
2026-02-21 Se agrega el port en la confguracion de la central
    Se agrega el port en la confguracion de la central
2026-07-09 Correcion en la configuracion
    Correcion en la configuracion
2026-07-10 Se saca config que no se usa
    Se saca config que no se usa
2026-07-10 Idicadores led
    Idicadores led
2026-07-12 Mejoras varias
    Mejoras varias
    Led indicador Send/Resp
    Mejora en tiempo de request
2026-07-12 Mejora en el tiempo de cierre el bajar archivo
    Mejora en el tiempo de cierre el bajar archivo
2026-07-12 Configuracion y estado de I/O
    Configuracion y estado de I/O
2026-07-12 COnfiguracion y control de I/O
    COnfiguracion y control de I/O
2026-07-13 Inicializacion de puertos corregida
    Inicializacion de puertos corregida
2026-07-13 Reporte de estados de I/O y cambios
    Reporte de estados de I/O y cambios
2026-07-16 Cambios en inicio y mensajeria
    Se corrige la deteccion de soporte SSL
    Se agrega informaciòn de compilacion en mensajeria
2026-07-18 Informacion de debug
    Informacion de debug
2026-08-13 Manejo de pulso, wiegand y configuraciones
    Manejo de pulso, wiegand y configuraciones
2026-08-14 Correcciones en configuración de I/O y Wiegand
2026-08-17 ADC Ok
    ADC Ok
2026-08-18 Poniendo un poco de orden
    Poniendo un poco de orden
2026-08-20 Soporte Wiegan 34 y Solicitud de configuracion
    Soporte Wiegan 34 y Solicitud de configuracion
2026-09-02 Mas info del modulo wifi en el log
    Mas info del modulo wifi en el log
2026-10-04 Manejo de mensajes fragmentados en query al host
    Manejo de mensajes fragmentados en query al host
2026-10-04 Correccion en mensaje de logueo
    Correccion en mensaje de logueo
2026-10-10 Saco servicio de cgi-bin
    Saco servicio de cgi-bin
2026-10-24 Se cambia el keep-alive por close en el POST HTTP
    Se cambia el keep-alive por close en el POST HTTP
2026-10-25 Mejoras en la comunicación
    Mejoras en la comunicación
